WATonomous/humanoid/src/simulation/humanoid_rl_tasks/humanoid_rl_tasks/push_block/assets/textures/speckled_gray.png

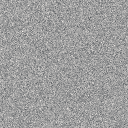
src/simulation/humanoid_rl_tasks/humanoid_rl_tasks/push_block/assets/textures/speckled_gray.png
