WATonomous/humanoid/src/simulation/humanoid_rl_tasks/humanoid_rl_tasks/push_block/assets/textures/wood_light.png

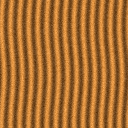
src/simulation/humanoid_rl_tasks/humanoid_rl_tasks/push_block/assets/textures/wood_light.png
