WATonomous/humanoid/docs/README.md

# Docs

The team's living documentation is the **humanoid-docs** site, not this repo:

<https://watonomous.github.io/humanoid-docs/index.html> · repo:
[`WATonomous/humanoid-docs`](https://github.com/WATonomous/humanoid-docs)

| Section | Covers |
|---|---|
| [Mechanical](https://watonomous.github.io/humanoid-docs/mechanical/) | Structure, actuators, hardware design |
| [Electrical](https://watonomous.github.io/humanoid-docs/electrical/) | Power, wiring, boards |
| [Interfacing](https://watonomous.github.io/humanoid-docs/interfacing/) | CAN, host ↔ hardware integration |
| [Firmware](https://watonomous.github.io/humanoid-docs/firmware/) | STM32 / ESP32 low-level control |
| [Software & ML](https://watonomous.github.io/humanoid-docs/software/) | Architecture, sim, teleop, imitation learning |
