WATonomous/humanoid/assets/lerobot/so101_vial_task/usd/tex/vial_opacity.png

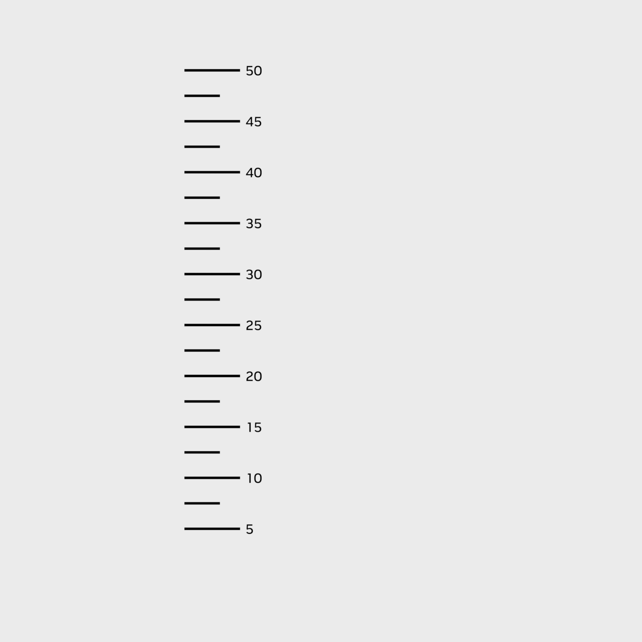
assets/lerobot/so101_vial_task/usd/tex/vial_opacity.png
