WATonomous/humanoid/assets/lerobot/so101_vial_task/usd/tex/vial_spec.png

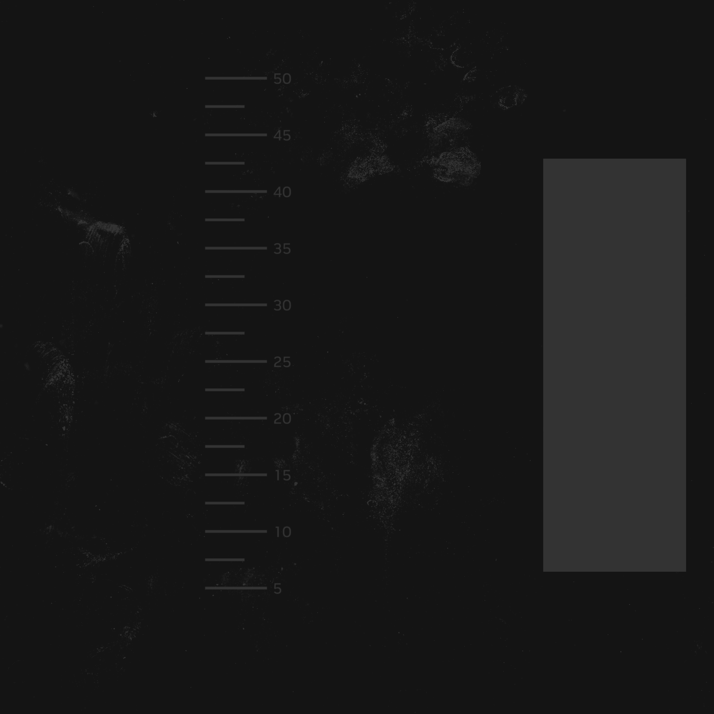
assets/lerobot/so101_vial_task/usd/tex/vial_spec.png
