WATonomous/humanoid/src/simulation/garment_fold_task/vendor_assets/scenes/Table038/texture/T_Table038_R001.png

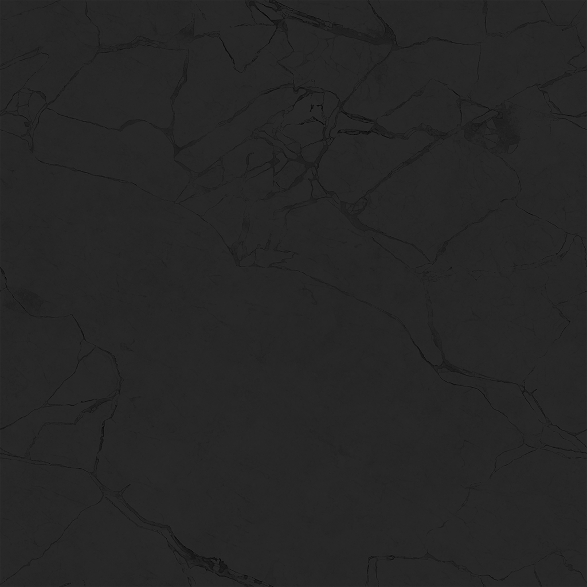
src/simulation/garment_fold_task/vendor_assets/scenes/Table038/texture/T_Table038_R001.png
