WATonomous/humanoid/src/simulation/humanoid_rl_tasks/humanoid_rl_tasks/push_block/assets/textures/wood_dark.png

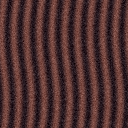
src/simulation/humanoid_rl_tasks/humanoid_rl_tasks/push_block/assets/textures/wood_dark.png
