WATonomous/humanoid/assets/pioneer_bimanual_arm/meshes/link6.STL

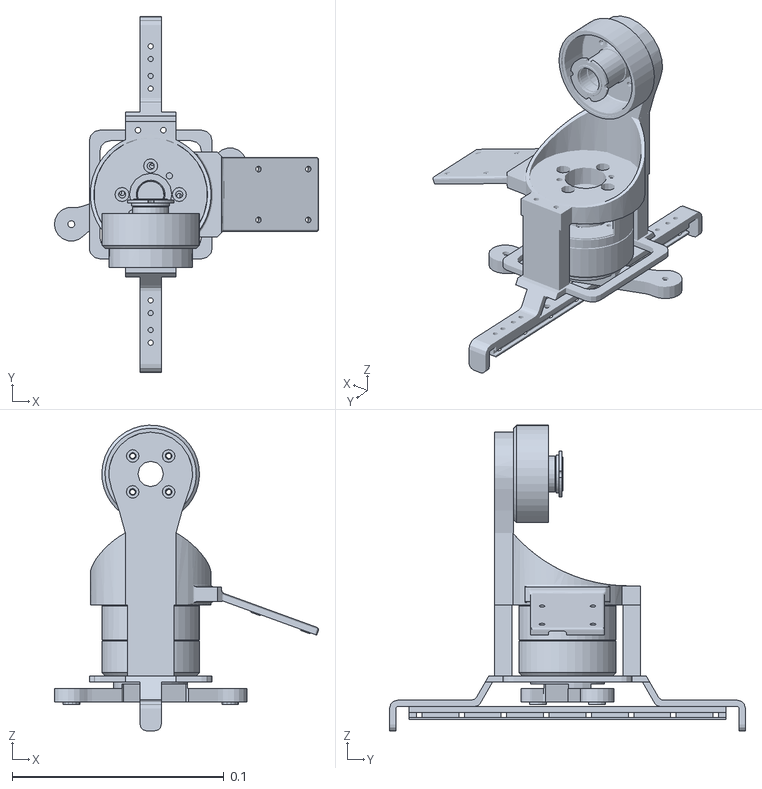
[picture p9: CAD file, 2026-08-22]
assets/pioneer_bimanual_arm/meshes/link6.STL
0.125 x 0.168 x 0.144
