WATonomous/humanoid/assets/pioneer_hand/meshes/distal_4.STL

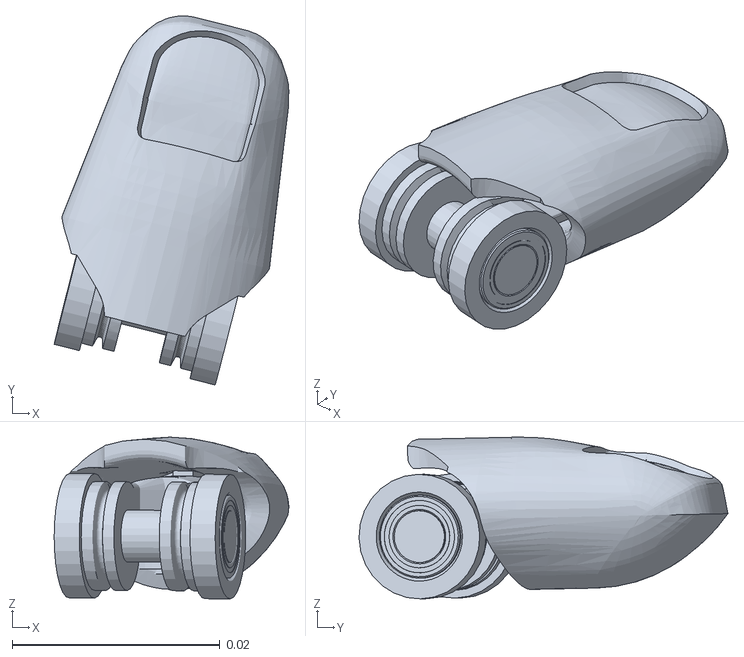
[picture p10: CAD file, 2026-07-09]
assets/pioneer_hand/meshes/distal_4.STL
0.0226 x 0.0356 x 0.0156
