WATonomous/humanoid/assets/whole_body_humanoid/meshes/Hip_A_L.STL

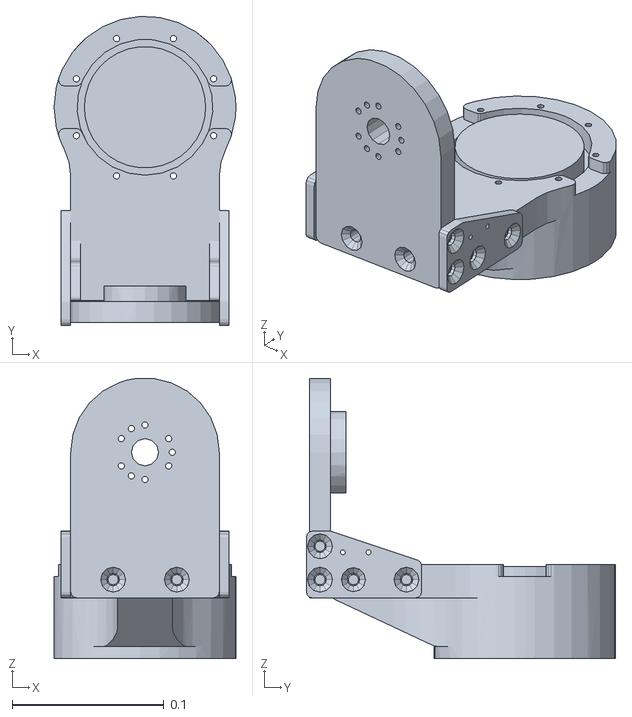
[picture p11: CAD file, 2026-07-13]
assets/whole_body_humanoid/meshes/Hip_A_L.STL
0.12 x 0.204 x 0.185
