WATonomous/humanoid/assets/pioneer_bimanual_arm/meshes/link2l.STL

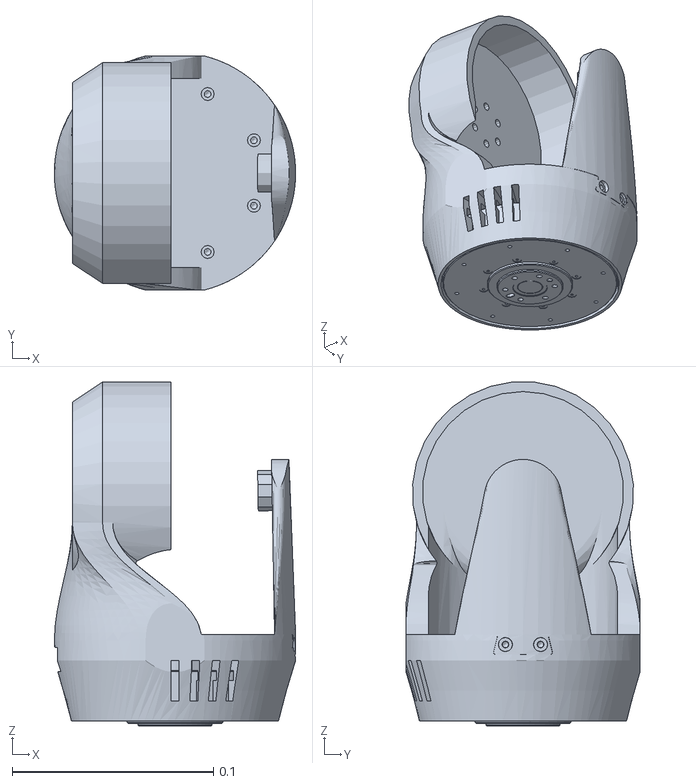
[picture p12: CAD file, 2026-08-22]
assets/pioneer_bimanual_arm/meshes/link2l.STL
0.12 x 0.116 x 0.171
