WATonomous/humanoid/assets/pioneer_hand/meshes/thumb_inter.STL

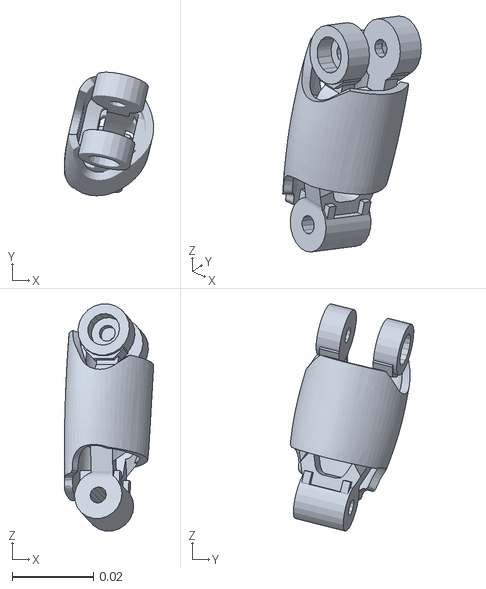
[picture p13: CAD file, 2026-07-09]
assets/pioneer_hand/meshes/thumb_inter.STL
0.022 x 0.0305 x 0.0559
