WATonomous/humanoid/assets/whole_body_humanoid/meshes/Hip_F_L.STL

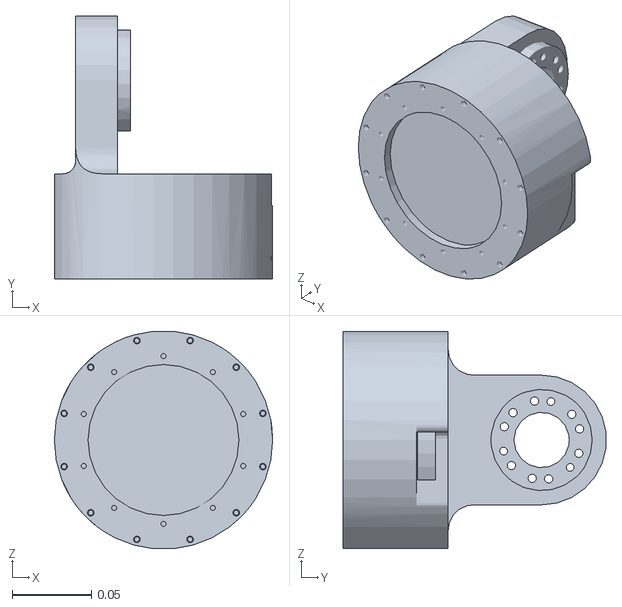
[picture p14: CAD file, 2026-07-13]
assets/whole_body_humanoid/meshes/Hip_F_L.STL
0.138 x 0.166 x 0.137
