WATonomous/humanoid/assets/pioneer_bimanual_arm/meshes/link3l.STL

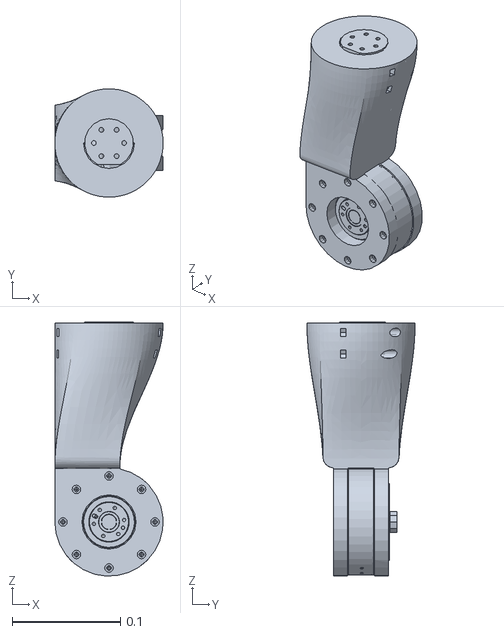
[picture p15: CAD file, 2026-08-22]
assets/pioneer_bimanual_arm/meshes/link3l.STL
0.1 x 0.1 x 0.234
