WATonomous/humanoid/assets/pioneer_hand/meshes/proximal_2.STL

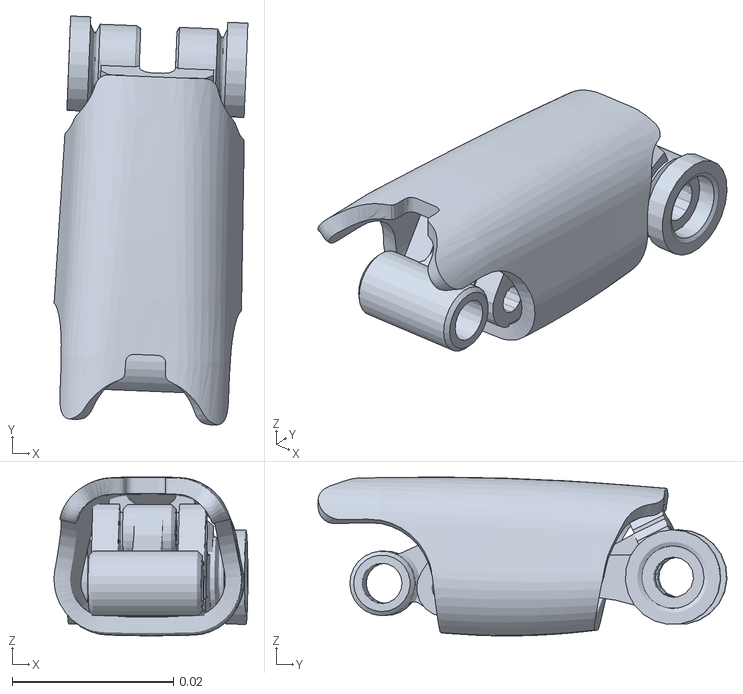
[picture p16: CAD file, 2026-07-09]
assets/pioneer_hand/meshes/proximal_2.STL
0.024 x 0.0507 x 0.0197
