WATonomous/humanoid/assets/whole_body_humanoid/meshes/Thigh_L.STL

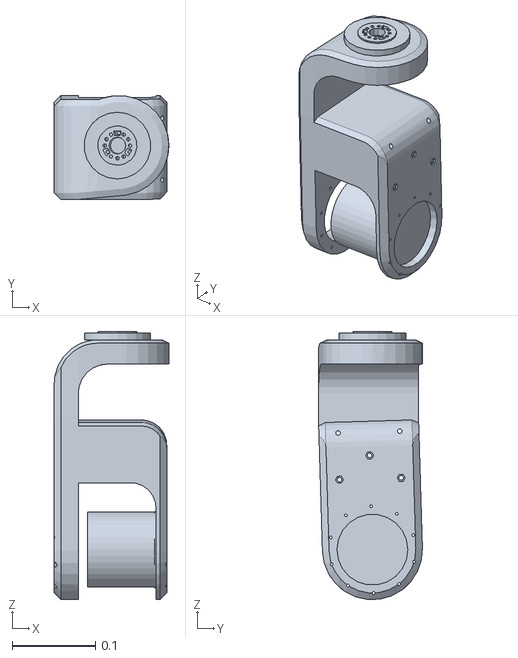
[picture p17: CAD file, 2026-07-13]
assets/whole_body_humanoid/meshes/Thigh_L.STL
0.137 x 0.125 x 0.321
