WATonomous/humanoid/assets/pioneer_bimanual_arm/meshes/link5.STL

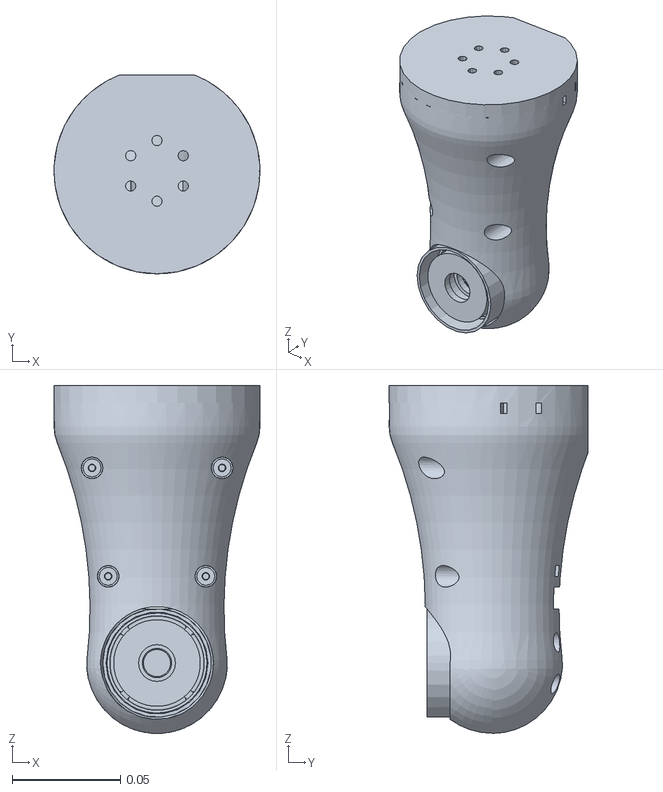
[picture p18: CAD file, 2026-08-22]
assets/pioneer_bimanual_arm/meshes/link5.STL
0.095 x 0.0917 x 0.161
