WATonomous/humanoid/assets/pioneer_hand/meshes/distal_2.STL

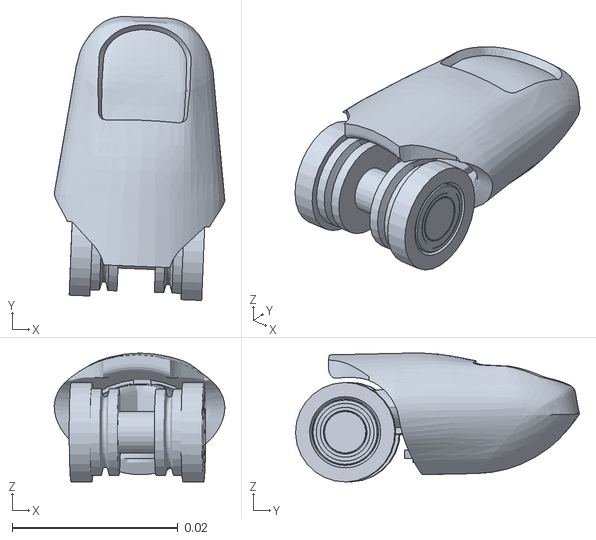
[picture p19: CAD file, 2026-07-09]
assets/pioneer_hand/meshes/distal_2.STL
0.0206 x 0.0343 x 0.0156
