WATonomous/humanoid/assets/whole_body_humanoid/meshes/Foot_L.STL

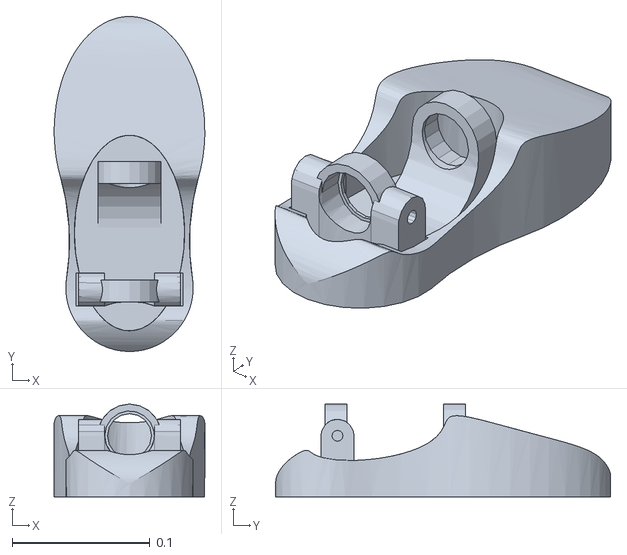
[picture p20: CAD file, 2026-07-13]
assets/whole_body_humanoid/meshes/Foot_L.STL
0.109 x 0.243 x 0.0675
