WATonomous/humanoid/assets/pioneer_bimanual_arm/meshes/link4.STL

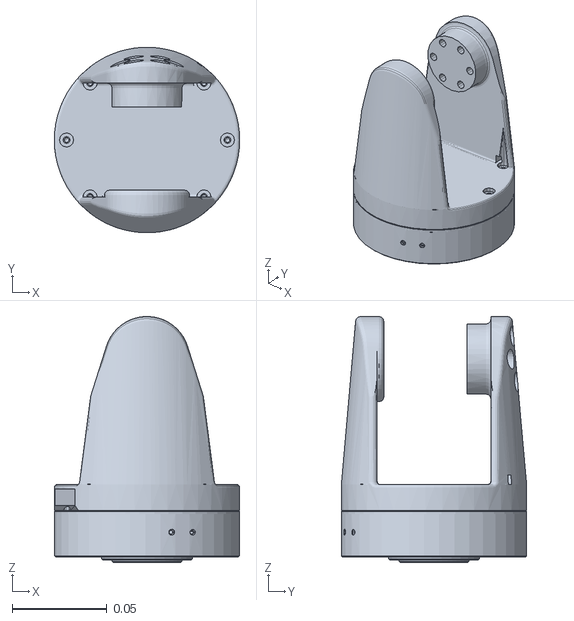
[picture p21: CAD file, 2026-08-22]
assets/pioneer_bimanual_arm/meshes/link4.STL
0.098 x 0.098 x 0.13
