WATonomous/humanoid/assets/pioneer_hand/meshes/inter_3.STL

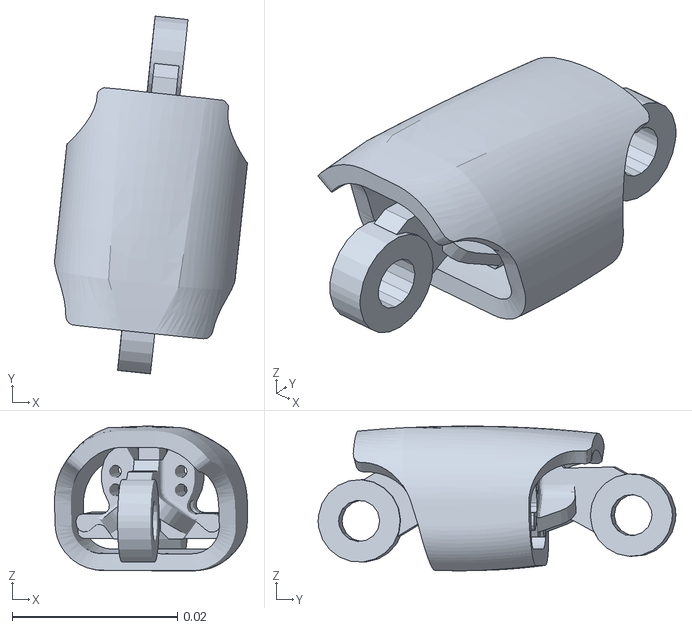
[picture p22: CAD file, 2026-07-09]
assets/pioneer_hand/meshes/inter_3.STL
0.0234 x 0.0433 x 0.0175
