WATonomous/humanoid/assets/whole_body_humanoid/meshes/Ankle_R.STL

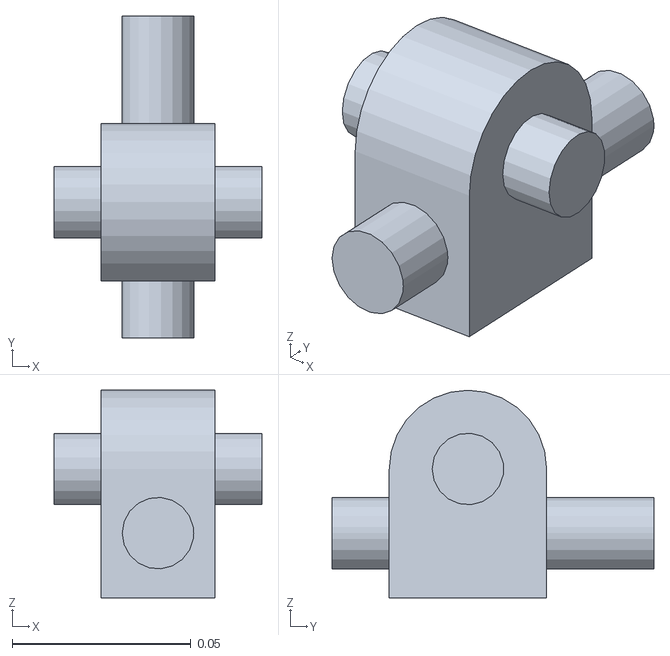
[picture p23: CAD file, 2026-07-13]
assets/whole_body_humanoid/meshes/Ankle_R.STL
0.058 x 0.09 x 0.058
