WATonomous/humanoid/assets/pioneer_bimanual_arm/meshes/link1L.STL

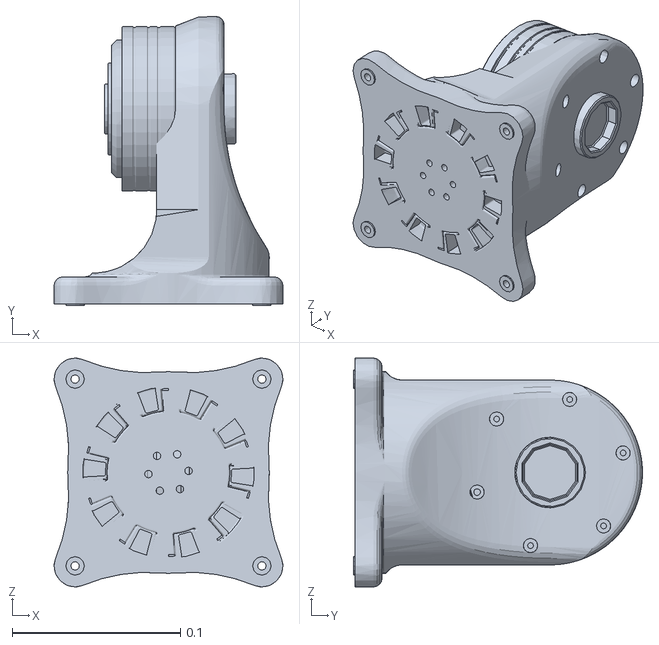
[picture p24: CAD file, 2026-08-22]
assets/pioneer_bimanual_arm/meshes/link1L.STL
0.136 x 0.172 x 0.136
