WATonomous/humanoid/assets/pioneer_hand/meshes/thumb_distal.STL

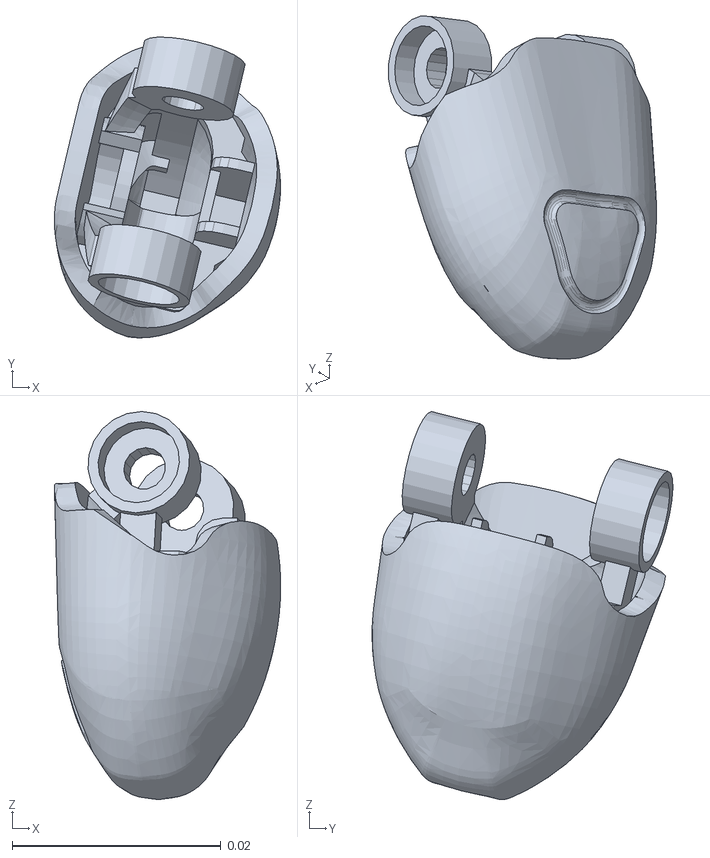
[picture p25: CAD file, 2026-07-09]
assets/pioneer_hand/meshes/thumb_distal.STL
0.0217 x 0.0288 x 0.0372
