WATonomous/humanoid/assets/whole_body_humanoid/meshes/Calf_L.STL

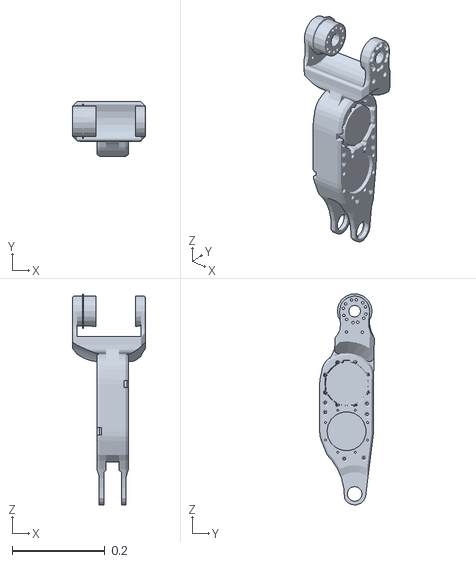
[picture p26: CAD file, 2026-07-13]
assets/whole_body_humanoid/meshes/Calf_L.STL
0.157 x 0.118 x 0.454
