WATonomous/humanoid/assets/pioneer_hand/meshes/distal_3.STL

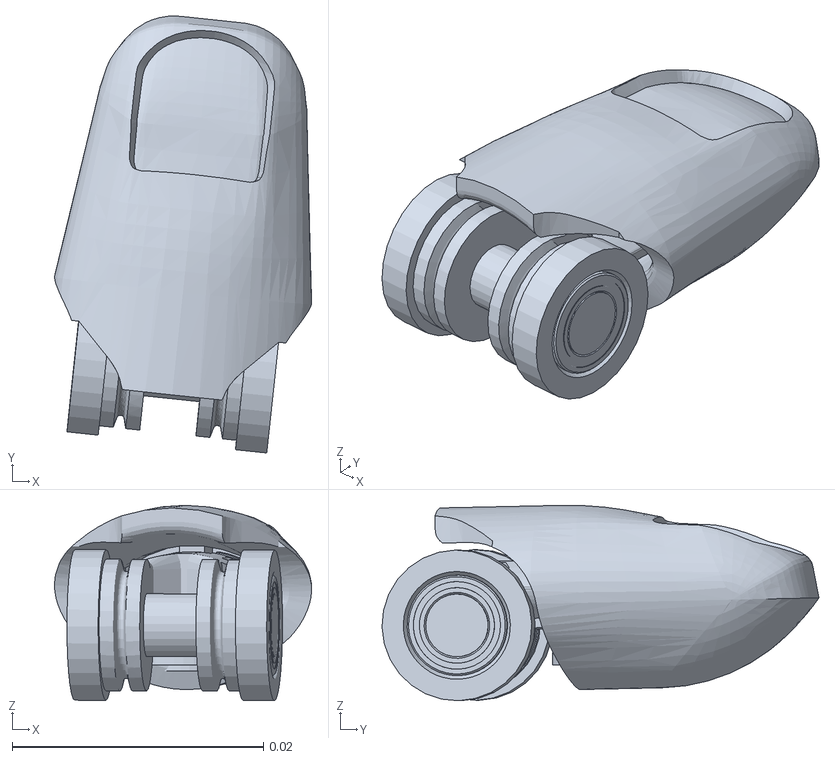
[picture p27: CAD file, 2026-07-09]
assets/pioneer_hand/meshes/distal_3.STL
0.0205 x 0.0348 x 0.0156
