WATonomous/humanoid/assets/pioneer_bimanual_arm/meshes/link7.STL

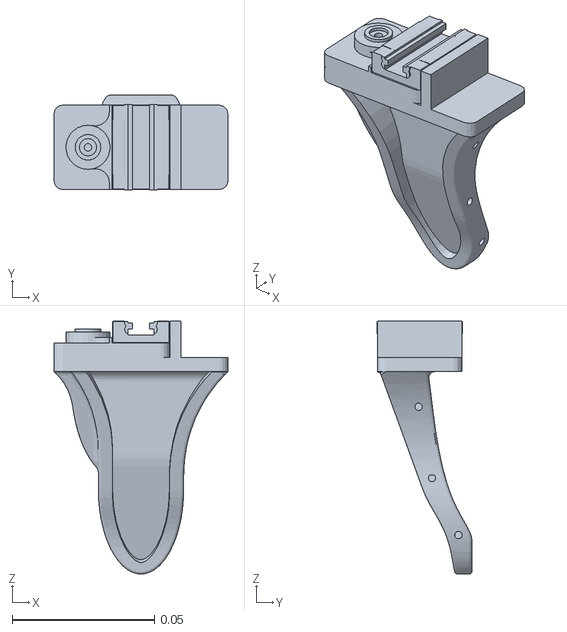
[picture p28: CAD file, 2026-08-22]
assets/pioneer_bimanual_arm/meshes/link7.STL
0.061 x 0.0334 x 0.0888
