WATonomous/humanoid/assets/pioneer_hand/meshes/hand_origin.STL

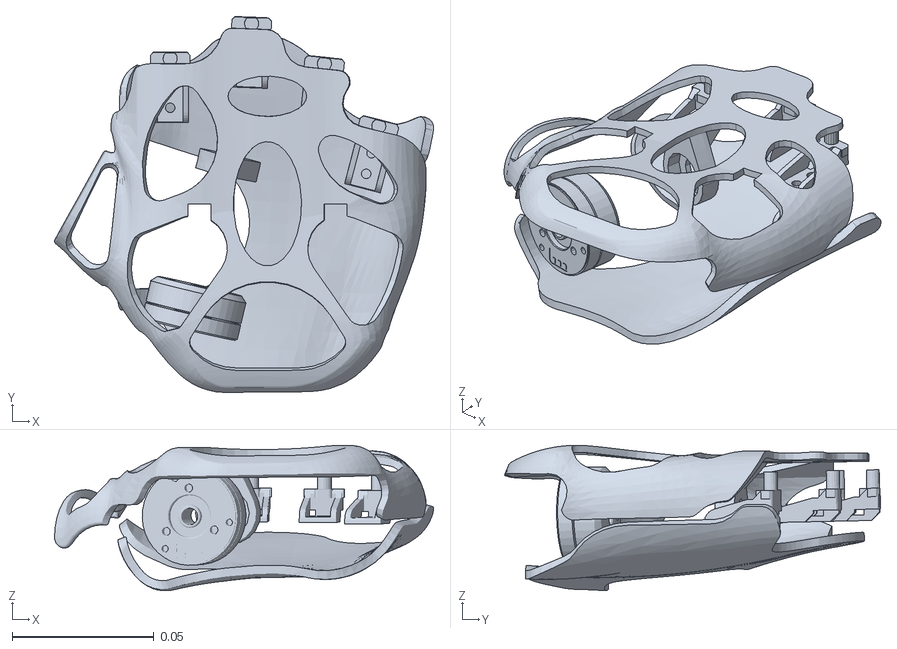
[picture p29: CAD file, 2026-07-09]
assets/pioneer_hand/meshes/hand_origin.STL
0.134 x 0.133 x 0.0513
