WATonomous/humanoid/assets/pioneer_hand/meshes/proximal_4.STL

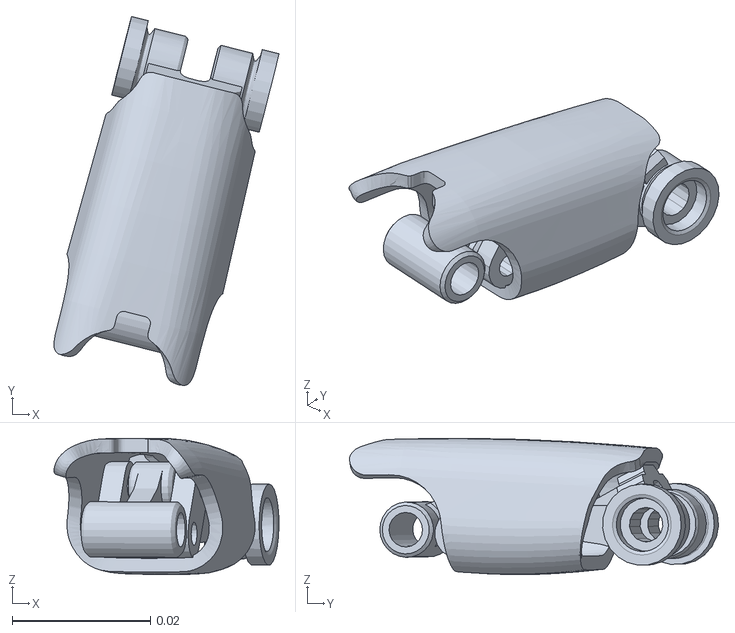
[picture p30: CAD file, 2026-07-09]
assets/pioneer_hand/meshes/proximal_4.STL
0.0325 x 0.0534 x 0.0197
