WATonomous/humanoid/assets/pioneer_hand/meshes/thumb_abduction.STL

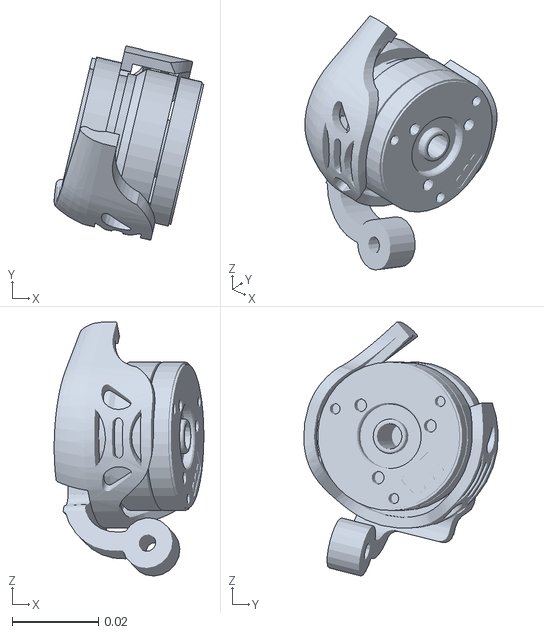
[picture p31: CAD file, 2026-07-09]
assets/pioneer_hand/meshes/thumb_abduction.STL
0.0348 x 0.0452 x 0.059
