WATonomous/humanoid/assets/pioneer_hand/meshes/abduction_1.STL

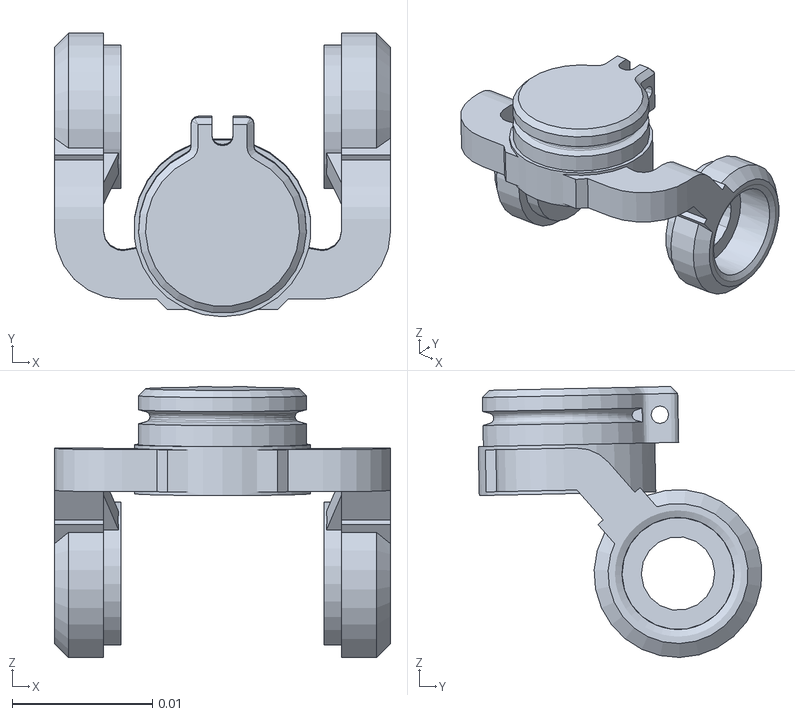
[picture p32: CAD file, 2026-07-09]
assets/pioneer_hand/meshes/abduction_1.STL
0.024 x 0.0203 x 0.0194
