WATonomous/humanoid/assets/pioneer_hand/meshes/inter_4.STL

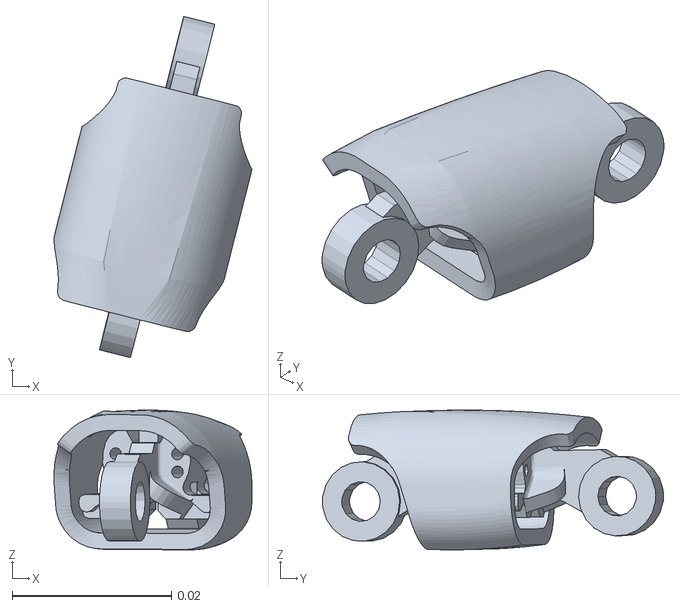
[picture p33: CAD file, 2026-07-09]
assets/pioneer_hand/meshes/inter_4.STL
0.0248 x 0.0428 x 0.0175
