WATonomous/humanoid/assets/whole_body_humanoid/meshes/base_link.STL

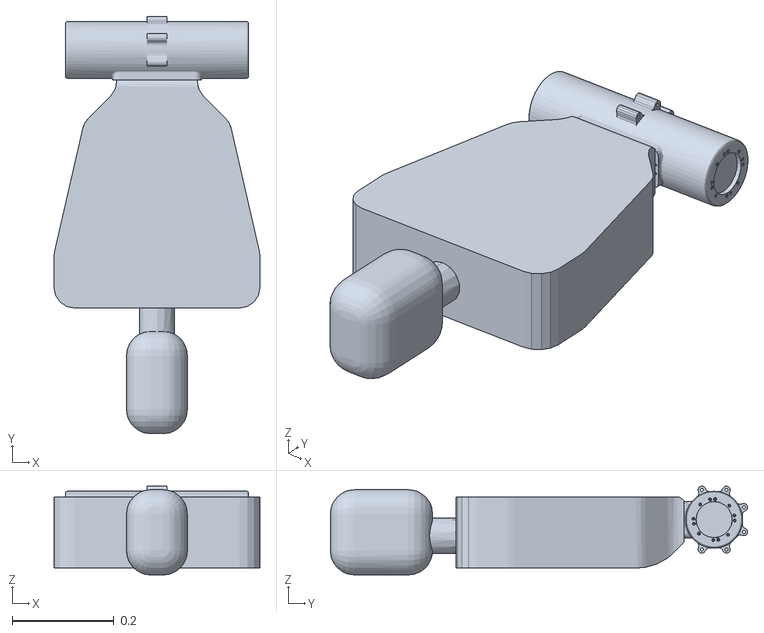
[picture p34: CAD file, 2026-07-13]
assets/whole_body_humanoid/meshes/base_link.STL
0.406 x 0.822 x 0.175
