WATonomous/humanoid/assets/pioneer_bimanual_arm/meshes/base_link.STL

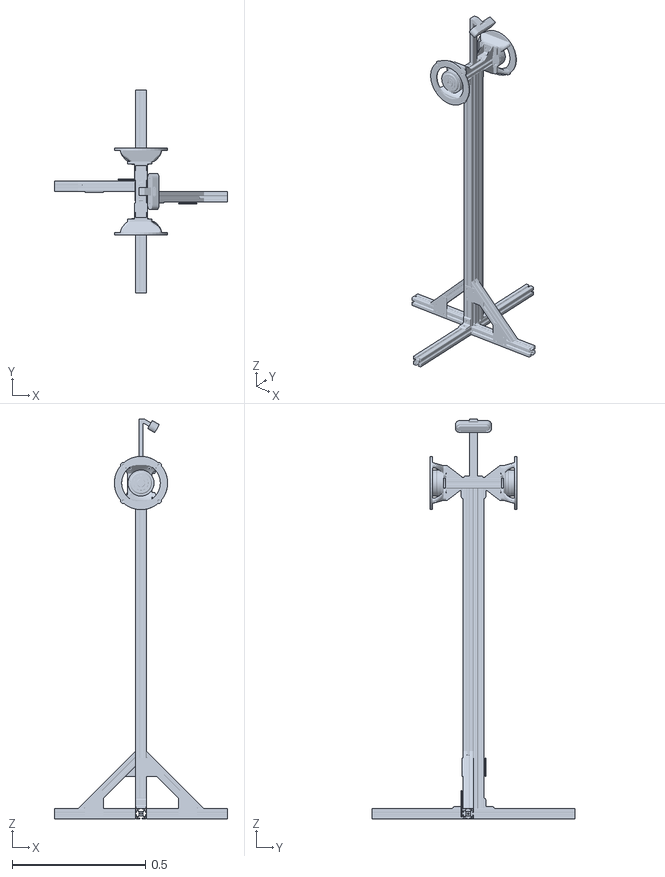
[picture p35: CAD file, 2026-08-22]
assets/pioneer_bimanual_arm/meshes/base_link.STL
0.65 x 0.762 x 1.50
