WATonomous/humanoid/assets/pioneer_hand/meshes/finger_3.STL

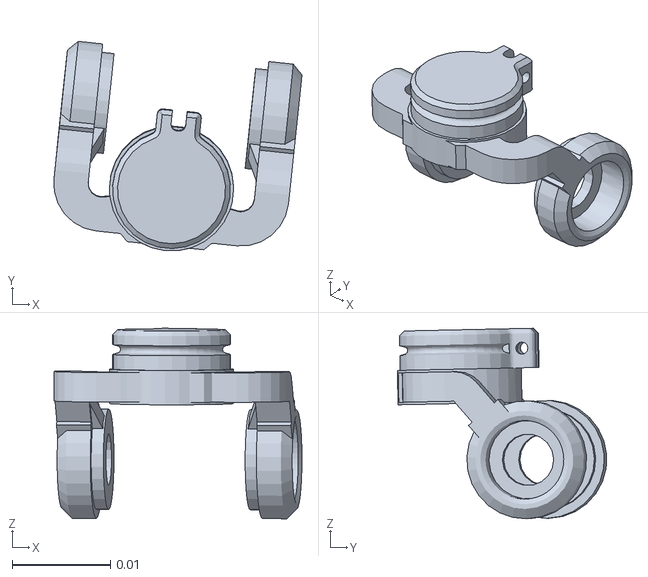
[picture p36: CAD file, 2026-07-09]
assets/pioneer_hand/meshes/finger_3.STL
0.0252 x 0.0213 x 0.0194
