WATonomous/humanoid/assets/pioneer_hand/meshes/finger_4.STL

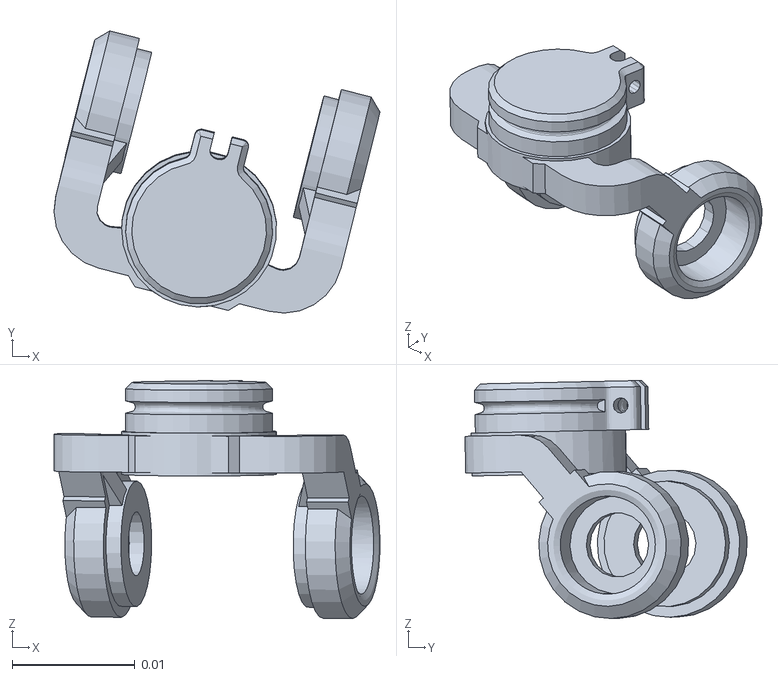
[picture p37: CAD file, 2026-07-09]
assets/pioneer_hand/meshes/finger_4.STL
0.0266 x 0.023 x 0.0194
