WATonomous/humanoid/assets/pioneer_hand/meshes/finger_1.STL

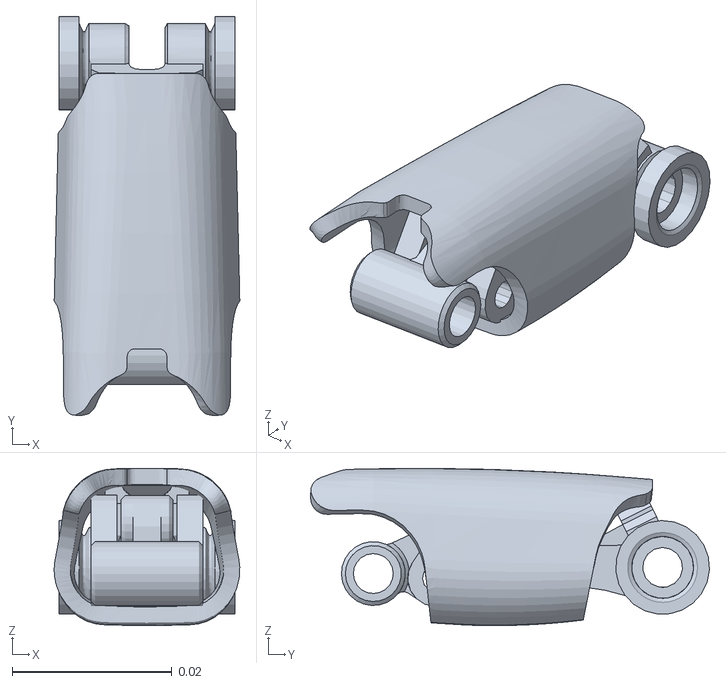
[picture p38: CAD file, 2026-07-09]
assets/pioneer_hand/meshes/finger_1.STL
0.0232 x 0.05 x 0.0197
