WATonomous/humanoid/assets/pioneer_hand/meshes/inter_1.STL

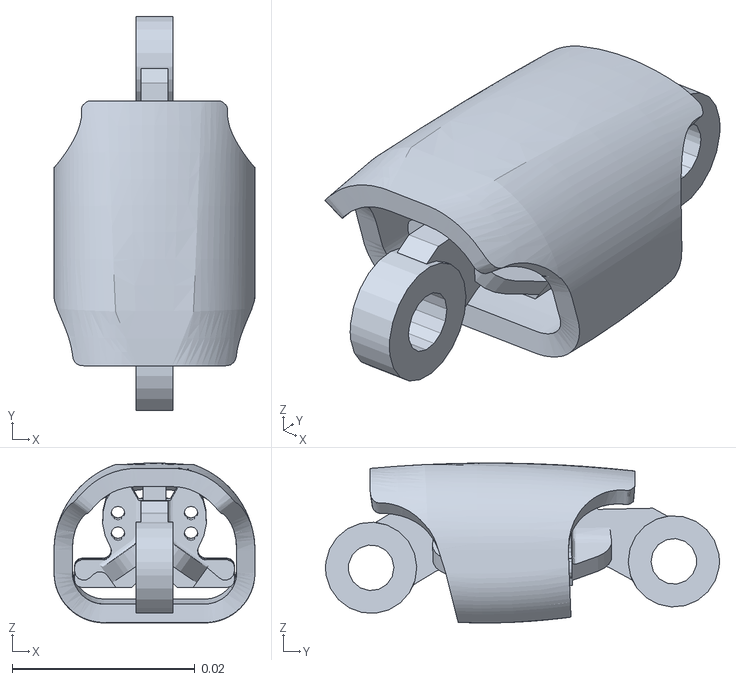
[picture p39: CAD file, 2026-07-09]
assets/pioneer_hand/meshes/inter_1.STL
0.022 x 0.0432 x 0.0175
