WATonomous/humanoid/assets/pioneer_hand/meshes/thumb.STL

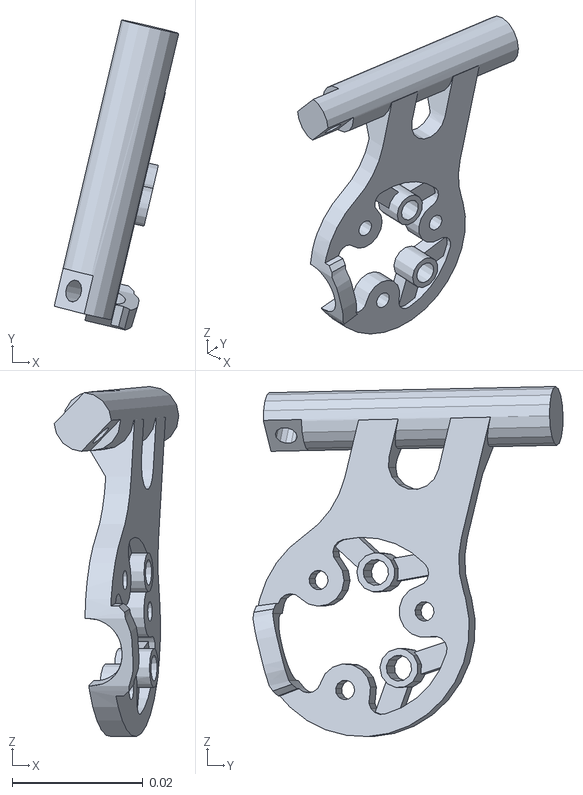
[picture p40: CAD file, 2026-07-09]
assets/pioneer_hand/meshes/thumb.STL
0.0191 x 0.0474 x 0.0535
