WATonomous/humanoid/assets/pioneer_hand/meshes/proximal_3.STL

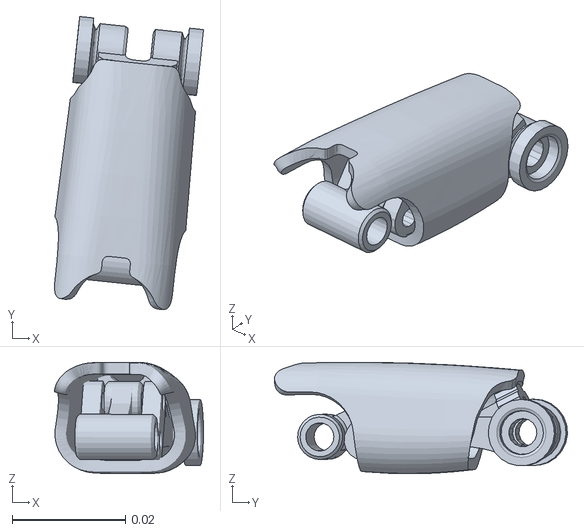
[picture p41: CAD file, 2026-07-09]
assets/pioneer_hand/meshes/proximal_3.STL
0.0263 x 0.0518 x 0.0197
