WATonomous/humanoid/(list of files, cad)

Other CAD files:
assets/pioneer_bimanual_arm/meshes/link5l.STL
assets/pioneer_hand/meshes/inter_2.STL
assets/whole_body_humanoid/meshes/Ankle_L.STL
assets/pioneer_bimanual_arm/meshes/link2.STL
assets/whole_body_humanoid/meshes/Thigh_R.STL
assets/whole_body_humanoid/meshes/Hip_A_R.STL
assets/pioneer_bimanual_arm/meshes/link6l.STL
assets/whole_body_humanoid/meshes/Hip_F_R.STL
assets/pioneer_bimanual_arm/meshes/link3.STL
assets/whole_body_humanoid/meshes/Calf_R.STL
assets/pioneer_bimanual_arm/meshes/link7l.STL
assets/whole_body_humanoid/meshes/Foot_R.STL
assets/pioneer_bimanual_arm/meshes/link4l.STL
assets/pioneer_bimanual_arm/meshes/link8l.STL
assets/pioneer_bimanual_arm/meshes/link8.STL
assets/pioneer_bimanual_arm/meshes/link1.STL
assets/pioneer_hand/meshes/finger_2.STL
assets/pioneer_hand/meshes/distal_1.STL
