WATonomous/humanoid/assets/whole_body_humanoid/usd/config.yaml

asset_path: /workspace/humanoid/assets/whole_body_humanoid/whole_body_humanoid.urdf
usd_dir: /workspace/humanoid/assets/whole_body_humanoid/usd
usd_file_name: whole_body_humanoid.usd
force_usd_conversion: false
make_instanceable: true
fix_base: false
root_link_name: base
link_density: 0.0
merge_fixed_joints: true
convert_mimic_joints_to_normal_joints: false
joint_drive:
  drive_type: force
  target_type: position
  gains:
    stiffness: 100.0
    damping: 5.0
collider_type: convex_hull
self_collision: false
replace_cylinders_with_capsules: false
collision_from_visuals: false
func: isaaclab.sim.spawners.from_files.from_files:spawn_from_urdf
visible: true
semantic_tags: null
copy_from_source: true
mass_props: null
deformable_props: null
rigid_props:
  rigid_body_enabled: null
  kinematic_enabled: null
  disable_gravity: false
  linear_damping: null
  angular_damping: null
  max_linear_velocity: null
  max_angular_velocity: null
  max_depenetration_velocity: 2.5
  max_contact_impulse: null
  enable_gyroscopic_forces: null
  retain_accelerations: null
  solver_position_iteration_count: null
  solver_velocity_iteration_count: null
  sleep_threshold: null
  stabilization_threshold: null
collision_props: null
activate_contact_sensors: true
scale: null
articulation_props:
  articulation_enabled: null
  enabled_self_collisions: false
  solver_position_iteration_count: 4
  solver_velocity_iteration_count: 4
  sleep_threshold: null
  stabilization_threshold: null
  fix_root_link: false
fixed_tendons_props: null
spatial_tendons_props: null
joint_drive_props: null
visual_material_path: material
visual_material: null
