WATonomous/humanoid/src/embedded/STM32/app/src/firmware.c

#include "../inc/common_defines.h"
#include "../inc/system.h"
#include "FreeRTOS.h"
#include "stm32g4xx.h"
#include "task.h"

#define BOOTLOADER_SIZE (0x08008000U)

// set the vector table offset of app firmware image
static void vector_setup(void) {
  SCB->VTOR = BOOTLOADER_SIZE;
}

// thread for blinking led
void blink_led(void* pvParams) {
  while (1) {
    HAL_GPIO_TogglePin(GPIOA, GPIO_PIN_5);
    // vTaskDelay(pdMS_TO_TICKS(500));
    HAL_Delay(500);
  }
}

int main() {
  vector_setup();
  HAL_Init();
  system_setup();

  __HAL_RCC_GPIOA_CLK_ENABLE();

  // Configure GPIO PIN5;
  GPIO_InitTypeDef GPIO_InitStruct;
  GPIO_InitStruct.Pin = GPIO_PIN_5;
  GPIO_InitStruct.Mode = GPIO_MODE_OUTPUT_PP;
  GPIO_InitStruct.Pull = GPIO_NOPULL;
  GPIO_InitStruct.Speed = GPIO_SPEED_FREQ_LOW;
  HAL_GPIO_Init(GPIOA, &GPIO_InitStruct);

  // create blinking led task
  xTaskCreate(blink_led, "BLINK_LED", 128, NULL, 1, NULL);

  // start FreeRTOS Scheduler
  vTaskStartScheduler();

  while (1)
    ;
}
