WATonomous/humanoid/src/embedded/STM32/src/Drivers/FDCAN_STM32.cpp

/* USER CODE BEGIN PFP */

#include "FDCAN_STM32.h"
#include <SimpleFOC.h>
FDCAN_HandleTypeDef hfdcan2;

static void check_can_bus(FDCAN_HandleTypeDef* hfdcan) {
  FDCAN_ProtocolStatusTypeDef protocolStatus = {};

  HAL_FDCAN_GetProtocolStatus(hfdcan, &protocolStatus);
  if (protocolStatus.BusOff) {
    CLEAR_BIT(hfdcan->Instance->CCCR, FDCAN_CCCR_INIT);
  }
}

void HAL_FDCAN_ErrorStatusCallback(FDCAN_HandleTypeDef* hfdcan, uint32_t ErrorStatusITs) {
  if (hfdcan == &hfdcan2) {
    if ((ErrorStatusITs & FDCAN_IT_BUS_OFF) != RESET) {
      check_can_bus(hfdcan);
    }
  }
}

void MX_FDCAN2_Init(void) {

  hfdcan2.Instance = FDCAN2;
  hfdcan2.Init.ClockDivider = FDCAN_CLOCK_DIV1;
  hfdcan2.Init.FrameFormat = FDCAN_FRAME_CLASSIC;
  hfdcan2.Init.Mode = FDCAN_MODE_NORMAL;
  hfdcan2.Init.AutoRetransmission = ENABLE;
  hfdcan2.Init.TransmitPause = DISABLE;
  hfdcan2.Init.ProtocolException = ENABLE;
  hfdcan2.Init.NominalPrescaler = 1;
  hfdcan2.Init.NominalSyncJumpWidth = 7;
  hfdcan2.Init.NominalTimeSeg1 = 40;
  hfdcan2.Init.NominalTimeSeg2 = 7;
  hfdcan2.Init.DataPrescaler = 2;
  hfdcan2.Init.DataSyncJumpWidth = 5;
  hfdcan2.Init.DataTimeSeg1 = 18;
  hfdcan2.Init.DataTimeSeg2 = 5;
  hfdcan2.Init.StdFiltersNbr = 1;
  hfdcan2.Init.ExtFiltersNbr = 0;
  hfdcan2.Init.TxFifoQueueMode = FDCAN_TX_FIFO_OPERATION;
  if (HAL_FDCAN_Init(&hfdcan2) != HAL_OK) {
    Error_Handler();
  }
}

static uint32_t HAL_RCC_FDCAN_CLK_ENABLED = 0;

void HAL_FDCAN_MspInit(FDCAN_HandleTypeDef* fdcanHandle) {

  GPIO_InitTypeDef GPIO_InitStruct = {0};
  RCC_PeriphCLKInitTypeDef PeriphClkInit = {0};
  if (fdcanHandle->Instance == FDCAN2) {
    /** Initializes the peripherals clocks
     */
    PeriphClkInit.PeriphClockSelection = RCC_PERIPHCLK_FDCAN;
    PeriphClkInit.FdcanClockSelection = RCC_FDCANCLKSOURCE_PLL;
    if (HAL_RCCEx_PeriphCLKConfig(&PeriphClkInit) != HAL_OK) {
      Error_Handler();
    }

    /* FDCAN2 clock enable */
    HAL_RCC_FDCAN_CLK_ENABLED++;
    if (HAL_RCC_FDCAN_CLK_ENABLED == 1) {
      __HAL_RCC_FDCAN_CLK_ENABLE();
    }

    __HAL_RCC_GPIOB_CLK_ENABLE();
    /**FDCAN2 GPIO Configuration
    PB12     ------> FDCAN2_RX
    PB13     ------> FDCAN2_TX
    */
    GPIO_InitStruct.Pin = GPIO_PIN_12 | GPIO_PIN_13;
    GPIO_InitStruct.Mode = GPIO_MODE_AF_PP;
    GPIO_InitStruct.Pull = GPIO_NOPULL;
    GPIO_InitStruct.Speed = GPIO_SPEED_FREQ_LOW;
    GPIO_InitStruct.Alternate = GPIO_AF9_FDCAN2;
    HAL_GPIO_Init(GPIOB, &GPIO_InitStruct);

    /* FDCAN2 interrupt Init */
    HAL_NVIC_SetPriority(FDCAN2_IT0_IRQn, 0, 0);
    HAL_NVIC_EnableIRQ(FDCAN2_IT0_IRQn);
    HAL_NVIC_SetPriority(FDCAN2_IT1_IRQn, 0, 0);
    HAL_NVIC_EnableIRQ(FDCAN2_IT1_IRQn);
  }
}

void HAL_FDCAN_MspDeInit(FDCAN_HandleTypeDef* fdcanHandle) {

  if (fdcanHandle->Instance == FDCAN2) {
    /* Peripheral clock disable */
    HAL_RCC_FDCAN_CLK_ENABLED--;
    if (HAL_RCC_FDCAN_CLK_ENABLED == 0) {
      __HAL_RCC_FDCAN_CLK_DISABLE();
    }

    /**FDCAN2 GPIO Configuration
    PB12     ------> FDCAN2_RX
    PB13     ------> FDCAN2_TX
    */
    HAL_GPIO_DeInit(GPIOB, GPIO_PIN_12 | GPIO_PIN_13);

    /* FDCAN2 interrupt Deinit */
    HAL_NVIC_DisableIRQ(FDCAN2_IT0_IRQn);
    HAL_NVIC_DisableIRQ(FDCAN2_IT1_IRQn);
  }
}
