WATonomous/humanoid/src/embedded/STM32/src/Drivers/ring_buffer.h

#ifndef RING_BUFFER_H
#define RING_BUFFER_H

#include "../../app/inc/common_defines.h"

#define RING_BUF_SIZE 128U

typedef struct ring_buffer_s {
  uint32_t read_index;
  uint32_t write_index;
  uint8_t* buf;
  uint32_t size;
} ring_buffer_t;

void ring_buffer_init(ring_buffer_t* rb, uint8_t* buf, uint32_t size);
bool ring_buffer_read(ring_buffer_t* rb, uint8_t* byte);
bool ring_buffer_write(ring_buffer_t* rb, uint8_t byte);
bool ring_buffer_empty(ring_buffer_t* rb);

#endif /* RING_BUFFER_H */
