WATonomous/humanoid/src/interfacing/can/scripts/joint_config.py

"""The arm's limits (hardware_mapping.yaml, safety_limits.yaml), read the way joint_command reads
them. Used by arm_roundtrip.py, telemetry_record.py and calibrate_arm.py. No ROS imports.

Frames (see joint_command_core.cpp applyCalibration):
  command frame  degrees, what ArmPose carries and what the limits are written in
  motor frame    direction * (q_cmd - zero_offset) degrees; MIT drives take it in radians
"""

from __future__ import annotations

from pathlib import Path
from typing import Any, Dict, List, Optional, Tuple

import yaml

# The six ArmPose slots, in message order -- identical to joint_command_core.cpp's jointPaths().
ARM_POSE_JOINTS = [
    ("shoulder", "pitch"), ("shoulder", "roll"), ("shoulder", "yaw"),
    ("elbow", "pitch"), ("elbow", "roll"), ("wrist", "pitch"),
]
ARM_POSE_NAMES = [f"{group}.{joint}" for group, joint in ARM_POSE_JOINTS]

# The repo copy, found relative to this file (src/interfacing/can/scripts -> src/interfacing).
_REPO_CONFIG = Path(__file__).resolve().parents[2] / "joint_command" / "config"

DEFAULT_MAPPINGS = [
    "/calibration/hardware_mapping.yaml",  # bind-mounted in both containers
    "/root/ament_ws/src/interfacing/joint_command/config/hardware_mapping.yaml",
    "/root/ament_ws/src/joint_command/config/hardware_mapping.yaml",
    str(_REPO_CONFIG / "hardware_mapping.yaml"),
]

SAFETY_LIMITS = [
    "/opt/joint_command_config/safety_limits.yaml",
    "/root/ament_ws/src/joint_command/config/safety_limits.yaml",
    "/root/ament_ws/src/interfacing/joint_command/config/safety_limits.yaml",
    str(_REPO_CONFIG / "safety_limits.yaml"),
]

# can/config/mit_profiles.yaml: which protocol family each drive speaks (gl2 | ak).
MIT_PROFILES = [
    str(Path(__file__).resolve().parent.parent / "config" / "mit_profiles.yaml"),
    "/opt/watonomous/can/share/can/config/mit_profiles.yaml",
]

# Keys a joint block may override; anything missing falls back to safety.global, exactly as
# JointCommandCore::loadJointSafetyConfig does.
_SAFETY_KEYS = ("velocity_max", "delta_max", "control_type", "mit_kp", "mit_kd",
                "mit_max_torque", "mit_max_track_err", "mit_feedback_timeout", "mit_family",
                "mit_fault_kd", "enable_position_clamp", "enable_velocity_limit",
                "gravity_ff_scale", "gravity_ff_max_torque", "urdf_direction", "urdf_offset_deg",
                "gravity_assume_deg")


def _first_existing(candidates: List[str]) -> Optional[Path]:
    for path in candidates:
        if path and Path(path).exists():
            return Path(path)
    return None


def find_mapping(explicit: Optional[str]) -> Path:
    found = _first_existing([explicit] if explicit else DEFAULT_MAPPINGS)
    if found is None:
        raise SystemExit("could not find hardware_mapping.yaml; pass --mapping PATH "
                         f"(looked in: {', '.join(DEFAULT_MAPPINGS)})")
    return found


def find_safety_limits(explicit: Optional[str]) -> Optional[Path]:
    return _first_existing([explicit] if explicit else SAFETY_LIMITS)


def drive_family(motor_id: int) -> Optional[str]:
    """mit_profiles.yaml family for this id (gl2 / ak), or None if unknown."""
    path = _first_existing(MIT_PROFILES)
    if path is None:
        return None
    motors = (yaml.safe_load(path.read_text(encoding="utf-8")) or {}).get("motors", {}) or {}
    return (motors.get(str(motor_id)) or {}).get("family")


def installed_joint_command_config() -> Optional[Path]:
    """joint_command_node's INSTALLED config dir -- what it enforces until rebuilt (needs ROS)."""
    try:
        from ament_index_python.packages import get_package_share_directory
        return Path(get_package_share_directory("joint_command")) / "config"
    except Exception:  # noqa: BLE001 - no ROS, or the package is not installed here
        return None


def same_yaml(a: Path, b: Path) -> bool:
    """Equal content, ignoring comments and formatting."""
    return (yaml.safe_load(a.read_text(encoding="utf-8")) ==
            yaml.safe_load(b.read_text(encoding="utf-8")))


def load_joint_map(path: Path, arm_side: str) -> Dict[int, dict]:
    """-> {motor_id: {"name", "direction", "zero_offset", "lower", "upper", "slot"}}"""
    data = yaml.safe_load(path.read_text(encoding="utf-8"))
    if arm_side not in data:
        raise SystemExit(f"arm side '{arm_side}' not in {path} (have {list(data)})")

    out: Dict[int, dict] = {}

    def walk(node, prefix: str) -> None:
        if not isinstance(node, dict):
            return
        if "can_id" in node:
            out[int(node["can_id"])] = {
                "name": prefix,
                "direction": float(node.get("direction", 1)) or 1.0,
                "zero_offset": float(node.get("zero_offset", 0.0)),
                "lower": float(node.get("lower_limit", float("-inf"))),
                "upper": float(node.get("upper_limit", float("inf"))),
                "limit_range": bool(node.get("limit_range", False)),
                "slot": None,
            }
            return
        for key, child in node.items():
            walk(child, f"{prefix}.{key}" if prefix else key)

    walk(data[arm_side], "")
    # Tag the six joints an ArmPose carries, so their setpoints can be matched up.
    for slot, (group, joint) in enumerate(ARM_POSE_JOINTS):
        node = data[arm_side].get(group, {}).get(joint)
        if node and int(node["can_id"]) in out:
            out[int(node["can_id"])]["slot"] = slot
    return out


def load_joint_safety(path: Optional[Path]) -> Tuple[Dict[str, Any], Dict[str, Dict[str, Any]]]:
    """-> (global block, {"group.joint": joint block merged over global})."""
    if path is None:
        return {}, {}
    cfg = (yaml.safe_load(path.read_text(encoding="utf-8")) or {}).get("safety", {}) or {}
    default = cfg.get("global", {}) or {}
    joints: Dict[str, Dict[str, Any]] = {}
    for group, members in (cfg.get("joints") or {}).items():
        for joint, node in (members or {}).items():
            node = node or {}
            joints[f"{group}.{joint}"] = {key: node.get(key, default.get(key))
                                          for key in _SAFETY_KEYS}
    return default, joints


def joint_safety(path: Optional[Path], name: str) -> Dict[str, Any]:
    """One joint's effective block; a joint with no entry (e.g. the gripper) gets global."""
    default, joints = load_joint_safety(path)
    if name in joints:
        return joints[name]
    return {key: default.get(key) for key in _SAFETY_KEYS}


def load_safety_limits(explicit: Optional[str]):
    """({joint: velocity_max_dps}, {joint: mit thresholds}) for the plots; empty if missing."""
    _, joints = load_joint_safety(find_safety_limits(explicit))
    vmax, mit = {}, {}
    for name, block in joints.items():
        vmax[name] = float(block.get("velocity_max") or 0)
        if int(block.get("control_type") if block.get("control_type") is not None else -1) == 0:
            mit[name] = {
                "mit_kp": block.get("mit_kp"),
                "mit_kd": block.get("mit_kd"),
                "max_torque_nm": block.get("mit_max_torque"),
                "max_track_err_deg": block.get("mit_max_track_err"),
            }
    return vmax, mit


def max_torque_by_joint(explicit: Optional[str]) -> Dict[str, float]:
    """Every joint's mit_max_torque, MIT or not -- the testing ceiling a run is judged against."""
    _, joints = load_joint_safety(find_safety_limits(explicit))
    return {name: float(block["mit_max_torque"]) for name, block in joints.items()
            if block.get("mit_max_torque") is not None}


def motor_to_cmd_deg(info: dict, motor_deg: float) -> float:
    """Inverse of joint_command's calibration: cmd = zero_offset + motor / direction."""
    return info["zero_offset"] + motor_deg / (info["direction"] or 1.0)


def cmd_to_motor_deg(info: dict, cmd_deg: float) -> float:
    """joint_command's calibration: motor = direction * (cmd - zero_offset)."""
    return (info["direction"] or 1.0) * (cmd_deg - info["zero_offset"])


def motor_frame_limits_deg(info: dict) -> Tuple[Optional[float], Optional[float]]:
    """Command-frame limits in the motor frame (deg, low first); (None, None) without limits."""
    if not info.get("limit_range"):
        return (None, None)
    a = cmd_to_motor_deg(info, info["lower"])
    b = cmd_to_motor_deg(info, info["upper"])
    return (min(a, b), max(a, b))
