WATonomous/humanoid/(commit log)

2023-08-21 created gazebo server docker container
    [building_robot.sdf]
2023-08-22 migrated monorepov2 infrastructure, setup gazebo ros bridge, full demo with gazebo, foxglove, and 3D lidar
    [building_robot.sdf, sensors_tutorial.sdf]
2023-08-30 added camera sensor and added robot urdf
    [building_robot.sdf, robot.urdf, robot_env.sdf]
2023-09-01 brought in samples and seccomp
2023-09-01 changing samples profile
2023-09-03 cleanup pycache and moved launch to src/gazebo
    [robot.urdf, robot_env.sdf]
2023-09-06 starting work on maze nav env
    [env.sdf, robot_env.sdf]
2023-09-06 added robot package and occupancy, nav, and control blank nodes
    [env.sdf, env.urdf]
2023-09-16 working new gazebo map
    [env.urdf, robot_env.sdf]
2024-01-21 fixing samples
2024-10-16 fixes to watod and tfs
    [env.urdf]
2024-11-20 costmap module
    [robot_env.sdf]
2024-12-29 adding an odometry spoofer
2025-01-07 completed assignment (this commit is intentional :3)
    [robot_env.sdf]
2025-01-08 fixes to merge conflicts
    [params.yaml]
2025-01-10 hotfix with urdf url
2025-01-16 fix env URDF
    [env.urdf]
2025-02-19 CI set up (#2)
    cli working - without sanitization
    [env.urdf, robot.urdf, robot_env.sdf]
2025-04-20 Miekale embedded structure (#6)
    * updating arch
    * Adding embedded directory, changing src -> autonomy
    * repairing actions
    * merging to main
    * actions updates
    * fix: naming convention
    * Fix code style issues with Autopep8
    * Fix code style issues with clang_format
    ---------
    [params.yaml]
2025-06-11 First iteration of arm pose message format (#11)
    * Create First Iteration of Common Message Formats
    * Update autonomy/wato_msgs/common_msgs/package.xml
    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
2025-07-12 Adding Humanoid Hand RL (#14)
    * Adding Humanoid Hand RL
    * Minor addition
    * bumping python version
    * repo clean up
    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
    [config.yaml]
2025-07-19 Add Simulation Kinematics Scripts
2025-07-19 Revert "Merge pull request #18 from WATonomous/fix-add-simulation-kinematics-scripts"
    This reverts commit f46af8351d94eb1c3b973566d521dc3943f6923d, reversing
    changes made to b91c1d8aff1c3a722b1de5117ee93e2598c3d6e2.
2025-10-19 Stm32 fdcan simple foc interfacing (#23)
    * Merged gimbal motor test code with humanoid repo on embedded branch
    * Initialized Platform IO STM32G474 development files
    * Updated Platform IO STM32G474 development files
    * bootloader with freeRTOS config (#15)
    * added FDCAN, Clock drivers
    * Added necessary FDCAN, TIMER driver files
    * Fix library capitalization
    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
    [FDCAN_STM32.cpp, FDCAN_STM32.h, SysClock.cpp, TIM.cpp, TIM.h]
2026-01-31 Refactor and optimize FDCAN driver implementation for STM32G474
2026-01-31 Enhance FDCAN driver performance and code structure for STM32G474
2026-02-06 Fix/repo cleaning (#27)
    * cleaning stm file
    * removing stm32 director and controller docker file
2026-02-06 new lint fix (#26)
    * new lint fix
    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
    [FDCAN_STM32.cpp, FDCAN_STM32.h, SysClock.cpp, TIM.cpp, TIM.h]
2026-02-19 Gtranqui interfacing (#30)
    * creating can package: debugging docker up
    * interfacing docker workind
    * updating to new structure
    * moving to autonomy
    * adding changes
    * Mounting CANable onto /dev/canable port
    * Convert CAN package to C++
    * Add CAN package README.md template
    * Added TODOs
    * Successfully run slcand to initialize can0 as a can device with master settings
    * Remove unecessary params
    * Added TODO comments on the empty functions
    * Add README.md
    * Add setup script comment
    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
    [can_core.cpp, can_core.hpp, can_node.cpp, can_node.hpp, params.yaml]
2026-03-11 update humanoid sim RL with full arm hand
    [CMC_THUMB_v1_1.stl, DIP_INDEX_v1_1.stl, DIP_MIDDLE_v1_1.stl, DIP_PINKY_v1_1.stl, DIP_RING_v1_1.stl, IP_THUMB_v1_1.stl, MCP_INDEX_v1_1.stl, MCP_MIDDLE_v1_1.stl]
2026-03-12 Improve arm hand RL
2026-03-18 add dex_retargeting library test with laptop camera
2026-04-24 Integrating DBC file for interfacing (#46)
    * initial messages
    * interfacing refactor, dbcppp installed
    * adding left flag, adding motor command callback
    * adding motorcmd, adding common_msgs, application builds
    * adding limiting bool
    * adding decode file, updating dbc to support dbcppp
    * installed dbc
    * adding encoding
    * dbc updates
    * updating can run, cube mars debugging, motor command update
    * working extended id publishing
    * adding multiple mode support for motors
    * adding publisher for motor feed back
    * removing comments
    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
    [hardware_mapping.yaml]
2026-05-06 Update MotorCmd.msg (#48)
2026-05-13 Fabrics dimension reduction test
    [arm_assembly.urdf]
2026-05-13 removing sim
    [arm_assembly.urdf]
2026-05-21 removing arm assembly msg
    [arm_assembly.urdf]
2026-05-21 trying again
    [arm_assembly.urdf]
2026-05-27 init camera pos
2026-07-09 feat: add camera/keyboard teleoperation and IL pipeline
    Squashed from PRs #57, #58, #59, #60, #67, #70.
    [armDouble.SLDASM.csv, armDouble.SLDASM.urdf, arm_assembly_fixed.urdf, base_link.STL, exportedthing.csv, exportedthing.urdf, link1.STL, link1L.STL]
2026-07-09 new changes
    [left_CMC_THUMB_v1_1.stl, left_DIP_INDEX_v1_1.stl, left_DIP_MIDDLE_v1_1.stl, left_DIP_PINKY_v1_1.stl, left_DIP_RING_v1_1.stl, left_IP_THUMB_v1_1.stl, left_MCP_INDEX_v1_1.stl, left_MCP_MIDDLE_v1_1.stl]
2026-07-09 Reorganized the files
    [arm_assembly_fixed.urdf, simple_door.urdf]
2026-07-09 Add SO101 vial-task assets under Git LFS.
    Track simulation USD/PNG via .gitattributes, migrate the existing SO101
    follower mesh to LFS, and vendor vial-task props from NVIDIA's workshop
    (lightbox, mat, vials, rack, textures) with a GitHub sync script.
2026-07-09 Added camera configuration for the intel realsense D455 config
2026-07-09 Consolidate Isaac Sim recording to single GPU-buffered strategy
    All Isaac Sim recording now uses SimLeRobotRecorder (GPU tensor buffering +
    async CPU flush) instead of the frame-by-frame RecordSession pattern.
    - Add humanoid_il/sim_recorder.py: generic SimLeRobotRecorder (no Isaac Sim
    deps, accepts numpy or torch, joint_names param, clean save/cancel API,
    num_episodes/is_complete, fixed __del__)
    - Delete humanoid_il/sim_session.py (create_sim_record_session removed)
    - Add [sim] optional dep group to humanoid_il pyproject.toml
    - Update so101_leader_teleop.py, so101_keyboard_teleop.py, keyboard_teleop.py
    to use SimLeRobotRecorder with EpisodeFlags/EpisodeKeyboard for S/N/D/Esc
    - Update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
2026-07-09 Store bimanual arm USD assets in git instead of LFS.
    Exclude wato_bimanual_arm from LFS so full mesh and USD files are committed directly.
2026-07-09 fix usd joint limit issue for task space controller'
2026-07-09 Add LEGR locomotion training setup (#95)
    Adds the LEGR robot model assets and Isaac Lab locomotion setup.
    This includes the LEGR articulation config, flat/rough locomotion task configs, reward terms, task registration, and diagnostic scripts for checking spawn, joints, and policy behavior.
    The setup was tuned iteratively through multiple training runs, then validated by training the flat LEGR task from scratch to 10k iterations. The final local checkpoint walks forward in play mode.
    [Abduction_L.STL, Abduction_R.STL, Calf_L.STL, Calf_R.STL, Flexion_L.STL, Flexion_R.STL, Foot_L.STL, Foot_R.STL]
2026-07-09 gripper VR teleop working, IK needs further tuning
2026-07-09 Collapse Quest teleop into single simulation_il container via native ROS2
    Eliminates the two-container UDP relay architecture (teleop + simulation_il).
    ROS2 Humble is now built from source inside simulation_il against Python 3.11
    (matching Isaac Sim 5.1's bundled interpreter ABI), so quest_teleop_node and
    the IK script run in the same container communicating over ROS2 topics directly.
    Removes quest_teleop_bridge.py and run_relay.sh (UDP middlemen no longer needed).
2026-07-09 Replace Differential IK with Pink IK and fix WSS cert trust flow
2026-07-09 Added push block task for so_arm_101
    [block.obj, box.obj]
2026-07-09 feat: implement MuJoCo MJX isolated pipeline for accelerated RL
    :wq
    [armDouble.SLDASM.csv, armDouble.SLDASM.urdf, base_link.STL, link1.STL, link1L.STL, link2.STL, link2l.STL, link3.STL]
2026-07-09 Clean up duplicate folders, reorganize push task files
    [block.obj, box.obj]
2026-07-09 chore: remove duplicate mojuco bimanual arm assets (pre-76aeb7f)
    [armDouble.SLDASM.csv, armDouble.SLDASM.urdf, base_link.STL, link1.STL, link1L.STL, link2.STL, link2l.STL, link3.STL]
2026-07-09 fix: resolve MuJoCo test script lint issues and reuse existing URDF assets
2026-07-09 migrate rl to new docker
    [hand_urdf.urdf]
2026-07-09 rename to bimanual arm
    [armDouble.SLDASM.csv, bimanual_arm.csv, bimanual_arm.urdf]
2026-07-10 Changed P matrix to have high uncertainty initially with velocity
2026-07-10 Seeded velocity with linear approximation in beginning
2026-07-10 Changed trajectory node to use PoseStamped sub, updated velocity seeding with more accurage dt info, chupdated trajectory pub to include a stamp
2026-07-10 added respawn logic if shuttle doesn't appear in frame for more than 3 seconds
2026-07-11 Potential fix for pull request finding
    [calibrate_arm.py]
2026-07-11 deployment files
    [hardware_mapping.yaml]
2026-07-13 Added cuRobo-based dataset generator for pick and place IL (#110)
    * Added cuRobo-based pick-and-place IL expert demo dataset generator
    * added more noise to path, cleaned up naming
    * forgot some files
    * created new environment for tray pick-and-place, updated readme, general cleanup
    * Remove cuRobo stack from shared isaac_lab Docker image
    * reverted names of usd files
    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
    [bimanual_arm_curobo.urdf]
2026-07-13 rl-locomotion-for-v1-leg (#120)
    [Abduction_L.STL, Abduction_R.STL, Ankle_L.STL, Ankle_R.STL, Calf_L.STL, Calf_R.STL, Flexion_L.STL, Flexion_R.STL]
2026-07-15 improve-locomotion-rl (#121)
    [Wato_Humanoid_V1_isaac.urdf]
2026-07-17 Fixing the IK for the VR Sim. (#119)
    * adding fixes for testing. Need see if the auto calibration works and follows up using office PC
    * Fixing the IK for the VR sim
    * new changes
2026-07-17 locomotion-rough-ground-rl (#142)
2026-07-17 Arm Interfacing tools (#143)
    * arm interfacing tools
    * fix
    * other fix
    [joint_command_core.cpp, joint_command_node.cpp]
2026-07-18 Vr changes (#149)
    * right arm working
    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
2026-07-18 mimicgen generated data (#135)
    * mimicgen
    * some cleaning
    * more cleaning
    * seperating pr
    * correction
    * more correction
    * Restore arm-interfacing files accidentally left out of mimicgen PR split.
    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
2026-07-18 RL-push-task-switch-to-bimanual-arm (#150)
2026-07-19 make-pioneer-arm-move (#155)
    * make-pioneer-arm-move
    * cleanup
2026-07-20 add-proper-calibration (#156)
    [bimanual_arm.urdf, bimanual_arm_curobo.urdf, hardware_mapping.yaml]
2026-07-20 fix clang-format violations in can_node.cpp
    [can_node.cpp]
2026-07-23 Adding safety check skill before running any scripts on the real Arm (#162)
    * Add .claude/ to .gitignore
    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
2026-07-23 adding POV VR teleop (#154)
    * adding POV VR teleop
    * Quest teleop: stereo head-fixed camera, real-arm bridge, OpenXR/CloudXR groundwork
    - Replace flat single-camera POV with a fixed stereo RealSense pair rendered
    as real per-eye textures inside the existing WebXR immersive session (true
    depth, no CloudXR dependency) -- camera precisely aimed at the arms' actual
    rest position via a computed look-at, not a guessed angle.
    - Add head_pose to QuestHandPose.msg/quest_message_parser.cpp (currently
    unused by the fixed camera, kept for a possible future head-tracked mode).
    - Add --publish-real-left-arm: bridges the live DLS IK solution to the real
    physical left arm via /behaviour/arm_pose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
2026-07-24 Changing Hardware Mapping to change positions of Motors (#163)
    * remove zeroing
    * remove other scripts
    * Remove accidentally-committed ov3660_camera.usd asset
    This unrelated camera USD asset was swept in by a broad `git add` in an
    earlier "other fix" commit alongside monitor_motor_feedback.py. It's not
    referenced anywhere in the codebase and isn't part of the arm-interfacing
    work this branch/PR is for.
    * Resolve unresolved merge-conflict markers in joint_command_node.cpp
    The armPoseCallback merge conflict from commit 6d1644e2 was left
    unresolved and committed as-is, breaking compilation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
    [hardware_mapping.yaml]
2026-07-31 Fix clang-format CI issue in foc.cpp (#170)
    [foc.cpp]
2026-08-10 Add wato_arm_v2 (armWithStand) USD asset (#172)
    Converted from the armWithStand URDF with a fixed base joint and
    the ground-clip fix applied, matching this repo's existing
    Isaac Sim asset conventions (base/physics/sensor/robot USD split).
    [armWithStand.csv, armWithStand.urdf, armWithStand_isaac.urdf, base_link.STL, link1.STL, link1L.STL, link2.STL, link2l.STL]
2026-08-22 Properly fix CI gate for empty build matrices (#186)
    * Properly fix CI gate for empty build matrices
    The previous fix (merged in #185) assumed an empty-matrix
    build-and-unittest job reports needs.result == "skipped", so the
    gate only failed on literal "failure". That assumption was wrong:
    GitHub reports needs.<job>.result as "failure" for a zero-entry
    matrix job, so the gate kept failing for the exact case it was
    meant to allow.
    Two real fixes:
    1. confirm-build-and-unittest-complete now reads the computed
    docker_matrix from setup-environment directly and checks its
    entry count, instead of trusting build-and-unittest's result.
    Zero entries = nothing to build for this diff = pass.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
2026-08-22 Adding the new URDF and USD files to the Repository + Removing unused USD/URDF files (#183)
    * new urdf + usd files
    * Remove accidentally-committed URDF exporter debug logs
    pioneer_bimanual_arm/export.log, pioneer_boxing_arm/boxingURDF/export.log,
    and pioneer_badminton_arm/export.log are raw stdout/debug output from the
    URDF export tool (8,954 lines combined, ~84% of this PR's total
    additions). They're not reproducible-build metadata or documentation --
    just tool output that adds no value in version control and would churn
    on every future re-export.
    Claude-Session: https://claude.ai/code/session_01Mzkt9bALC8oUqQKCN6upNm
    Co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
    [CMC_THUMB_v1_1.stl, DIP_INDEX_v1_1.stl, DIP_MIDDLE_v1_1.stl, DIP_PINKY_v1_1.stl, DIP_RING_v1_1.stl, IP_THUMB_v1_1.stl, MCP_INDEX_v1_1.stl, MCP_MIDDLE_v1_1.stl]
2026-08-25 Add isaac_screenshot harness for remote Isaac Sim scene iteration (#205)
    * Add isaac_screenshot harness for remote Isaac Sim scene iteration
    Claude Code Remote Control has no physical access to the monitor, so
    iterating on IsaacLab scenes remotely needs a way to launch a script,
    wait for it to be ready, and grab a real screenshot of the running GUI
    window — GNOME's screenshot D-Bus/portal APIs require an interactive
    click and don't work headless. Wraps xwd + a manual XWD->PNG decoder,
    plus the launch gotchas learned the hard way (no --experience flag,
    $DISPLAY varies across reboots, never SIGKILL Isaac Sim, Python stdout
    buffering hides print() markers).
    * Add multi-view + headless captu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
2026-08-25 Add persistent Isaac Sim session daemon for fast iterative scene building (#206)
    * Add persistent Isaac Sim session daemon for fast iterative scene building
    Every isaac_screenshot.sh / isaac_multiview_screenshot.sh command relaunches
    Isaac Sim from scratch (~15-40s even with a warm shader cache) — fine for a
    single check, wasteful when iterating on the same scene repeatedly (nudging
    object positions, checking several placements against a screenshot, building
    up a scene incrementally). This adds a long-lived alternative: one Isaac Sim
    process stays running and takes commands over a file-based queue shared with
    the host via the repo's existing bind mount, so each command afterward costs
    a f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
2026-08-25 Rename isaac_screenshot to isaac_harness, fix bimanual arm spawn (#207)
    * Rename tools/isaac_screenshot -> tools/isaac_harness
    The folder started as just a screenshot capture tool but grew into a
    full session daemon with structured scene introspection — the name
    undersold what's actually in there now.
    * Add spawn_bimanual_arm daemon command and a reusable vial-rack scene script
    Generic spawn_usd --articulation builds a bare ArticulationCfg with no
    actuators and fails outright for this repo's actual robot:
    TypeError: Missing values detected in object ArticulationCfg for
    the following fields:
    - actuators
    spawn_bimanual_arm spawns it correctly instead, using the real
    BIMANUAL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
2026-08-25 Fix daemon ground plane offset, add isaac-harness Claude skill (#208)
    * Set daemon's ground plane to the robot's actual bbox-derived Z
    Was hardcoded at 0.0 (visibly intersecting the table/robot base) then
    manually tuned to -1.0 by trial and error across several screenshots.
    Queried bbox on the spawned Robot instead: true lowest point is
    z=-1.1997, meaning -1.0 was still cutting ~0.2m into the base mount
    (not obvious from render angles since that part of the mesh is thin).
    -1.2 puts the tripod base feet flush on the floor, confirmed visually
    (the feet are now visible at all, previously hidden below ground).
    * Add isaac-harness Claude Code skill
    Captures the hard-won lessons from building t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
2026-08-25 Remove non-functional apply_physics option from spawn_usd
    spawn_usd's --apply-physics flag did not successfully enable physics
    for bare-mesh USD assets with no baked-in RigidBodyAPI (e.g. YCB
    props) — spawning such an asset still failed with a missing-rigid-
    body error regardless of the flag. Removes the option and its
    client-side arguments; root cause remains open in a follow-up issue.
    Retains the unrelated, verified-working fix from the prior commit:
    process_command now clears builtins.ISAACLAB_CALLBACK_EXCEPTION after
    every call, so a failed spawn's stored exception is not re-raised and
    misattributed to subsequent, unrelated commands.
2026-08-26 Fix set_pose not surviving reset, and remove corrupting other Articulations
    Both were previously open, documented workarounds in issue #209 — real
    root causes found this time, not further guesses.
    set_pose: a real (non-soft) sim.reset() calls PhysX stop() then play(). On
    PLAY, a rigid body's pose is re-initialized from the USD prim's authored
    xformOp transform on the stage, not from cfg.init_state or
    data.default_root_state (both of which two earlier fix attempts targeted).
    write_root_pose_to_sim() only ever writes the live physics tensor, never
    the prim's actual USD attributes (confirmed: query() reflected a new pose
    instantly, but bbox() of the same prim right after showed the transform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
2026-08-30 Remove wato_constants.py; keep only pick-place task geometry
    `wato_constants.py` existed as an Isaac-free mirror of the arm's joint
    limits / default pose / EE bodies so the cuRobo pipeline could import them
    without pulling in isaaclab. cuRobo was archived in PR #187 and every
    remaining importer runs inside Isaac Lab, so the arm half is now redundant
    (and had drifted — the held-arm default pose no longer matched
    bimanual_arm_cfg.py).
    - Delete wato_constants.py (137 lines).
    - Add pick_place_gen/task_geometry.py (56 lines): only the constants actually
    consumed — table slab, workspace box, grasp-yaw count, tray geometry, and
    the gripper approach frame (FINGERTIP_OFFSET_IN_WRIST / APPROA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
2026-08-31 Retarget Quest teleop to pioneer_bimanual_arm (#218)
    * Add Quest VR teleop for wato_arm_v2 (armWithStand)
    Adapts run_quest_bimanual_teleop.py for the new armWithStand.usd
    asset: dedicated armWithStand_v2_cfg.py (joint limits/gains/
    fingertip geometry re-derived for this asset's different joint
    axes, not copied from bimanual), the VR teleop script itself with
    a live-tuned stereo RSD455 head camera, a single-arm keyboard
    teleop variant for quick bench testing, and a helper script to
    open the bare USD scene for visual inspection.
    * Tune stereo head camera position/orientation via live feedback
    Restored a clean forward-facing gaze (~50d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
    [pioneer_bimanual_arm.urdf]
2026-08-31 Consolidate the pioneer_bimanual_arm config into the pioneer_humanoid package (stacked on #218) (#221)
    * consolidate: pioneer_bimanual_arm_cfg.py is the one canonical arm config
    - rename armWithStand_v2_cfg.py -> pioneer_bimanual_arm_cfg.py,
    ARM_V2_CFG -> PIONEER_BIMANUAL_ARM_CFG
    - split the data-collection camera config (ego_cam/wrist_cam) out to
    teleop_cameras.py -- it is teleop-scene setup, not a robot property
    - repoint run_quest_bimanual_teleop.py at both
    No behaviour change.
    Claude-Session: https://claude.ai/code/session_01EtusD8QWFBLpdMUZPpye5B
    * consolidate: delete bimanual_arm_cfg.py, migrate all consumers to pioneer_bi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
2026-09-01 keyboard teleop: persistent absolute-pose IK + Shift for fine control
    The IK felt laggy/mushy vs task_space_ik.py. Two causes:
    1. Relative mode (use_relative_mode=True) re-anchored the target to the
    *measured* tip every step, so a held key made the arm chase a moving
    carrot -- steady-state lag, and it stalled near joint limits while you
    kept pressing.
    2. apply_delta_pose composes the rotation delta as quat_mul(delta, current)
    -- pre-multiply -- so Z/X/T/G/C/V rotated about the base axes, not the
    tool axes, which tumbles a tilted wrist unexpectedly.
    Now (matching task_space_ik.py): absolute-pose mode against a persistent
    target seeded from the tip, integrating the keyboard de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
2026-09-01 keyboard teleop: add --scene {bare,push}; restore box.usd
    keyboard_teleop.py always built the bare ground+light+arm scene. New
    pioneer_humanoid.teleop_scenes module:
    bare (default) ground + light + arm -- unchanged behaviour
    push arm on its floor stand facing a lightbox enclosure + work
    table, with the push-block ramp-box + block on the table
    The push scene puts the arm on the ground (lifted 1.1997 m onto its stand,
    feet at z=0) facing the table -- NOT the old RL push layout where the arm
    sat at table height. Table + lightbox geometry come from the Quest scene
    (run_quest_bimanual_teleop.py); the ramp-box (box.usd) and block (block.usd)
    keep push_env_cf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
2026-09-01 ci: add pre-commit (checks only) + protect watod-config.sh
    - .pre-commit-config.yaml: structural checks — large-file guard (blocks
    accidental multi-hundred-MB asset commits), merge-conflict / case-conflict
    / symlink / submodule checks, Python-parses, TOML-valid. No whole-repo
    reformat; formatters can be layered on later.
    - pre-commit.yml: runs `pre-commit run --all-files` on every PR + main push.
    - block_watod_config_change.yml: fails a PR that edits watod-config.sh
    (shared defaults) — personal settings belong in watod-config.local.sh.
    Run `pre-commit install` once locally to get the git hook.
    Claude-Session: https://claud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
2026-09-01 Rename autonomy/ -> src/ ; move embedded/ -> src/embedded/
    Standardise the first-party source layout: everything under src/ (ROS
    packages, sim, teleop, IL), with firmware in src/embedded/ alongside them.
    "autonomy/" never matched what's in there anyway.
    Pure move + reference update:
    - git mv autonomy src ; git mv embedded src/embedded
    - sweep autonomy/ -> src/ and embedded/ -> src/embedded/ in Dockerfiles,
    compose files, watod scripts, CI (check_src_changes, linting), setup.cfg,
    .gitignore, .clang-format-ignore, all READMEs, and the few hard-coded
    paths in Python (isaac_session_daemon, teleop docstrings/help text)
    - parents[N] path anchors are unchanged (folder depth is identical)
    py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
    [Ankle_L.STL, Ankle_R.STL, Calf_L.STL, Calf_R.STL, Foot_L.STL, Foot_R.STL, Hip_A_L.STL, Hip_A_R.STL]
2026-09-01 watod: collapse to one editable container per module
    Drop the deploy/dev split entirely. This repo has no autonomous robot
    operation and CI doesn't exercise the deploy stage, so the duality (global
    MODE_OF_OPERATION, a <module> + <module>_dev service pair, deploy/develop
    profiles) was cost with no benefit -- and for most modules the two services
    were near-identical anyway.
    Now: ACTIVE_MODULES="interfacing simulation_isaac" -> one bind-mounted,
    editable container per module. Shell in with `watod -t <service>`, launch /
    rebuild by hand.
    - modules/*.yaml: collapse each module's two services into one (keeping the
    dev variant's command + the bind mount), remove every `profiles:` line,
    drop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
2026-09-01 Fix stale clang-format-ignore path after autonomy/ -> src/ rename
    #229's rename swept autonomy/ -> src/ but left the FreeRTOS-Kernel exclude
    as `embedded/STM32/lib/**` (now `src/embedded/STM32/lib/**`), so clang-format
    started failing on ~30 vendored third-party files on every PR.
    Verified: full-repo clang-format --dry-run --Werror is clean.
    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
2026-09-01 clang-format: actually exclude vendored FreeRTOS-Kernel
    The CI clang_format check (wato-lint-action) globs every C/C++ file and runs
    clang-format on it explicitly. It does NOT honour .clang-format-ignore
    (that needs a clang-format version / invocation the runner doesn't have),
    so the ~31 vendored FreeRTOS-Kernel files under src/embedded/STM32/lib/ have
    been failing the check with tens of thousands of "errors" on every PR.
    Fix: a nested `.clang-format` with `DisableFormat: true` in that dir. That
    is honoured by every clang-format version regardless of how it's invoked, so
    the vendored files become a no-op. Verified: full first-party C/C++ sweep is
    clean, with and without .clang-format-ignore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
2026-09-01 dev containers: run as the host user (no root-owned bind-mount files)
    Each module Dockerfile gains a `develop` stage that creates a user matching
    the host UID/GID (passed by watod as build args) and switches to it. Files a
    dev container writes into the bind-mounted src/<module> come out owned by
    you, not root -- no more sudo to clean colcon build output / __pycache__.
    - docker/{interfacing,perception,behaviour/*,simulation/mjlabs}.Dockerfile:
    + develop stage (useradd + passwordless sudo + chmod 711 /root so the
    non-root user can traverse into /root/ament_ws + chown the workspace)
    - modules/*.yaml: build.target=develop, pass USER_UID/USER_GID/USERNAME
    - watod-setup-docker-env.sh: write U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
2026-09-01 sim: promote pioneer_humanoid to a top-level src/ package (#247)
    [armv2URDF.csv, base_link.STL, link1.STL, link1L.STL, link2.STL, link2l.STL, link3.STL, link3l.STL]
2026-09-01 modules: dissolve `behaviour` into interfacing + perception
    The `behaviour` module held joint_command and voxel_grid/octo_map -- none of
    which is "behaviour" in the autonomy-stack sense (planning / decision FSM). The
    name was carried over from an AV monorepo; this repo is end-to-end learned
    policy and has no behaviour layer.
    - joint_command -> src/interfacing/joint_command/ (it only exists to feed the
    CAN layer: ArmPose -> calibrate + safety-moderate -> MotorCmd -> can; always
    deployed with interfacing). Now a second service in docker-compose.interfacing.
    - voxel_grid + octo_map -> src/perception/{voxel_grid,octo_map}/ (depth ->
    occupancy world model). src/perception/ becomes a mult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
    [hardware_mapping.yaml]
2026-09-01 push: one scene module, on the teleop-verified grounding (#250)
2026-09-02 robots: consolidate modelCfg into pioneer_humanoid, drop the "wato" name (#257)
    The RL robot configs lived 4 dirs deep in HumanoidRLSetup/modelCfg/. They're
    robot configs, not RL — move them flat into the pioneer_humanoid package
    alongside bimanual_arm.py, and rename off the old org name:
    modelCfg/humanoid_arm_hand.py -> pioneer_humanoid/arm_hand.py
    modelCfg/wato_hand.py -> pioneer_humanoid/hand.py
    modelCfg/wato_humanoid_v1.py -> pioneer_humanoid/whole_body.py
    INHAND_WATO_HAND_CFG -> INHAND_HAND_CFG
    WATO_HUMANOID_V1_CFG -> WHOLE_BODY_HUMANOID_CFG
    Consumers (badminton, inhand x3, locomotion, camera_teleop, splay_demo) now
    `from pioneer_humanoid.<name> import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
2026-09-02 teleop_scenes.py -> humanoid_scenes; teleop_cameras.py -> src/teleop/ (#259)
    pioneer_humanoid is the robot-configs package; teleop scene wiring and recording
    cameras don't belong in it.
    - teleop_scenes.py deleted. Its jobs move into humanoid_scenes:
    - the `bare` scene -> humanoid_scenes/bare/scene.py (@scene("bare"))
    - the `push` legacy shim -> humanoid_scenes/push_block/scene.py (sys.path into
    HumanoidRLPackage + re-register the imported PushBlockSceneCfg; replaced by
    the real scene when push is flattened, #245)
    - scene_names/build_scene_cfg/camera_for were already covered by
    humanoid_scenes.list_scenes / make_scene_cfg / scene_camera
    - keyboard_teleop uses humanoid_sce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
2026-09-02 sim: flatten RL runner + tasks into src/ packages (humanoid_rl, humanoid_rl_tasks) (#260)
    First step of the src/simulation/ RL-tree flatten (#245). Extracts the two
    least-active tasks and the shared runner out of the deeply-nested
    Humanoid_Wato/HumanoidRL/HumanoidRLPackage/HumanoidRLSetup/ tree:
    - src/simulation/humanoid_rl/ — installable; RSL-RL train/play/diagnose
    runners (was HumanoidRLPackage/rsl_rl_scripts/, minus the push-specific
    distill scripts which move with push later)
    - src/simulation/humanoid_rl_tasks/ — installable; flat one-folder-per-task,
    seeded with inhand + locomotion. __init__ registers envs via import_packages,
    same mechanism Isaac Lab's own suite us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
2026-09-02 Archived: remove the Isaac Lab badminton task (#265)
    Superseded by the mjlab badminton environment (#179) — a full rewrite on the
    simulation_mj stack with a v2 arm + racket, court, and aerodynamics. The Isaac
    version was the earlier attempt and its only robot config (arm_hand.ARM_CFG)
    points at a USD that was deleted in #183.
    `arm_hand.py` / `ARM_CFG` is now used only by src/teleop/camera_teleop/, which
    is being archived in a follow-up.
    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
2026-09-02 Archived: remove camera_teleop + dead arm_hand.py (#266)
    * Archived: remove the Isaac Lab badminton task
    * Archived: remove camera_teleop + the dead arm_hand.py config
    camera_te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
2026-09-02 reorg: shared USD props -> src/simulation/assets/; drop dead badminton arm dir (#267)
    - UsdModelAssets/{block,box}.usd + Table/table.usd -> src/simulation/assets/
    (consumers: push_block scene, quest_isaac_teleop)
    - pioneer_badminton_arm/ + empty arm_assembly/ deleted — zero references
    (badminton is mjlab now, #179)
    pioneer_boxing_arm/ kept for now — pending confirmation it's unused by Ramy's
    AMP / motion-prior work.
    Part 1 of dissolving src/simulation/Humanoid_Wato/. wato_hand/ and the V1
    humanoid model fold into pioneer_humanoid/ next.
    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
    [badmintonURDF.csv, base_link.STL, link1.STL, link1L.STL, link2.STL, link2l.STL, link3.STL, link3l.STL]
2026-09-02 reorg: fold wato_hand/ into pioneer_humanoid/ (Humanoid_Wato part 2) (#268)
    - Humanoid_Wato/wato_hand/wato_hand_cfg.py -> pioneer_humanoid/pioneer_humanoid/hand_cfg.py
    (symbol WATO_HAND_CFG -> HAND_CFG)
    - Humanoid_Wato/wato_hand/{urdf,meshes,config} -> pioneer_humanoid/assets/hand/
    - hand.py drops the sys.path hack -> `from .hand_cfg import ...`
    - dead ROS/gazebo scaffolding (CMakeLists, package.xml, launch/, export.log) removed
    - splay_demo.py removed — unreferenced one-off demo (in git history if needed)
    Humanoid_Wato/ now down to the V1 humanoid model + Ramy's boxing arm.
    Claude-Session: https://claude.ai/code/session_01EtusD8QWFBLpdMUZPpye5B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
    [abduction_1.STL, distal_1.STL, distal_2.STL, distal_3.STL, distal_4.STL, finger_1.STL, finger_2.STL, finger_3.STL]
2026-09-02 reorg: V1 humanoid model -> assets/whole_body_humanoid/; RL checkpoints -> outputs/rl/; delete Humanoid_Wato/ (#269)
    Part 3 (final) of dissolving src/simulation/Humanoid_Wato/.
    Asset move / rename:
    - "Wato Humanoid Simultion Model V1/urdf/Wato_Humanoid_V1_isaac{.urdf,_usd/}"
    -> src/simulation/assets/whole_body_humanoid/{whole_body_humanoid.urdf, usd/}
    - top USD Wato_Humanoid_V1.usd -> whole_body_humanoid.usd
    - meshes/ -> assets/whole_body_humanoid/meshes/
    - raw SolidWorks export (space-named files) + dead ROS scaffolding: deleted
    - pioneer_boxing_arm/ deleted (preserved in Ramy's branch)
    - Humanoid_Wato/ is gone
    RL checkpoints:
    - train.py / play.py / distill_push.py log_root -> $HUMANOID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
    [Ankle_L.STL, Ankle_R.STL, Calf_L.STL, Calf_R.STL, Foot_L.STL, Foot_R.STL, Hip_A_L.STL, Hip_A_R.STL]
2026-09-02 reorg: all robot/prop assets -> repo-root assets/ (backend-neutral) (#270)
    URDF/USD/meshes are robot description consumed by any sim backend; keeping them
    under src/pioneer_humanoid/ (an Isaac Lab package) or src/simulation/ couples
    them to one backend. Move to the repo root, alongside the existing assets/lerobot/.
    - src/pioneer_humanoid/assets/pioneer_bimanual_arm/ -> assets/pioneer_bimanual_arm/
    - src/pioneer_humanoid/assets/hand/ -> assets/pioneer_hand/
    - src/simulation/assets/whole_body_humanoid/ -> assets/whole_body_humanoid/
    - src/simulation/assets/{block,box,table}.usd -> assets/props/
    - urdf_joint_limits.py (was living in the arm asset dir, imported via sys.pa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
    [Ankle_L.STL, Ankle_R.STL, Calf_L.STL, Calf_R.STL, Foot_L.STL, Foot_R.STL, Hip_A_L.STL, Hip_A_R.STL]
2026-09-02 sim: drop the last "wato" naming from the RL task configs (#272)
    Renames the locomotion + inhand task configs to match the assets they use
    (assets/whole_body_humanoid, assets/pioneer_hand) and the pioneer_humanoid
    package:
    locomotion:
    - config/wato_humanoid_v1/ -> config/pioneer_humanoid_v1/
    - WatoHumanoid{Rough,Flat}{EnvCfg,Rewards,Terminations,PPORunnerCfg} -> PioneerHumanoid*
    - WATO_{LEG,FOOT,ANKLE}_JOINTS / WATO_BASE_BODY -> {LEG,FOOT,ANKLE}_JOINTS / BASE_BODY
    - gym: Isaac-{Locomotion,Velocity}-{Flat,Rough}-WatoHumanoid*-v0 -> *-PioneerHumanoid*-v0
    - experiment_name wato_humanoid_{flat,rough} -> pioneer_humanoid_{flat,rough}
    inhand:
    - config/wato_hand/ -> config/pioneer_hand/ ; wato_ha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
2026-09-02 sim: promote 5 RL policy baselines to models/; delete Humanoid_Wato/ for good (#274)
    The only thing keeping src/simulation/Humanoid_Wato/ alive was ~19 MB of old
    committed training checkpoints under HumanoidRL/logs/. Curate the useful ones,
    drop the rest, delete the directory.
    - models/{push, push_distill, pioneer_hand_cube, pioneer_humanoid_flat,
    pioneer_humanoid_rough}/ — one .pt each, the baselines worth sharing
    (dirs renamed to the post-#272 task names)
    - removed: cabinet_humanoid_arm/ + reach_humanoid_arm/ checkpoints (tasks deleted
    long ago) and every intermediate model_N / tfevents / params file
    - new models/README.md — baselines vs live runs (outputs/rl/, gitignored)
    - Hum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
2026-09-17 Merge pull request #179 from WATonomous/s532yang/badminton-rl
    sim: badminton receive RL environment (mjlab, stationary arm)
2026-09-19 sim: fix eval reset/RTC autograd bugs, add generic RTC driver for flow-matching policies (#286)
2026-10-01 Pioneer v1 sim schema, gripper fix, camera recording (#297)
    * Pioneer v1 sim schema + keyboard teleop gripper fix
    - keyboard_teleop: drop the line that overwrote right_gripper_ids with the
    idle arm's joint7/joint8, so K now drives the teleoperated arm's gripper.
    The idle arm's fingers are held open via HELD_GRIPPER_* instead.
    - Recording: 7 values per frame (6 arm joints + gripper closure 0-1), one
    frame every 4th physics step (25 fps at 100 Hz physics), rate_limit=False.
    _init_recorder validates joint_names and that fps divides the physics rate.
    - dataset_schema_sim.yaml: pioneer_v1_left_arm_sim, real-robot joint names,
    fps 25, gripper added.
    - il README updated to match.
    Co-Aut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
2026-10-01 One Pioneer v1 dataset schema for sim and real (#299)
    * il: one Pioneer v1 schema for sim and real recording
    - dataset_schema_pioneer_v1.yaml replaces dataset_schema.yaml (real) and
    dataset_schema_sim.yaml: 7 joints (6 + left_gripper), 25 fps, cameras
    ego / wrist_left / wrist_right at 256x256. Sim writes <root>/sim, real
    writes <root>/real.
    - schema.select_cameras(): shared --cameras handling for keyboard_teleop
    and humanoid-record.
    - humanoid-record: stops at startup when the schema needs something the
    real arm can't supply yet (left_gripper, cameras without a topic);
    center-crops and resizes camera frames to the schema size; dry run
    uses schema image sizes; robot_type comes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
    [dataset_schema_pioneer_v1.yaml]
2026-10-01 Rename src/il to src/robot_learning; remove SO101 teleop (#301)
    * rename src/il -> src/robot_learning (humanoid_robot_learning)
    - Folder src/robot_learning, package humanoid_robot_learning, pip
    humanoid-robot-learning; CLI humanoid-record unchanged.
    - Isaac image aliases: train-policy, record-demos, eval-policy
    (were il-train, il-record, il-eval).
    - All imports, paths and docs updated (teleop, so101_vial_task, Dockerfile,
    READMEs, DEVELOPING.md).
    - README: robot_learning = learning from recorded datasets (ACT, SmolVLA,
    pi0.5); RL is sim-based (Isaac Lab) and stays in src/simulation/humanoid_rl*.
    Also drops the stale pick_place entry from the repo map.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
2026-10-01 teleop: Pioneer leader-arm teleop (any scene, recording) (#305)
    * teleop: pioneer_leader_teleop (7-servo leader arm, any scene, recording)
    Moves NotMax08's leader-arm code from #296 into src/teleop/pioneer_leader_teleop:
    - servo_leader.py, encoder_test.py: as in #296, minus the 5-servo map and the
    vendored-SDK path (feetech-servo-sdk is in the Isaac image).
    - arm_limits.py: gripper_fraction / limited_target; joint targets are clamped
    to the arm's URDF limits instead of the leader's travel; a NaN reading holds
    the home pose.
    - pioneer_leader_teleop.py: from #296's leader_teleop.py and recorder values
    (signs 1,-1,-1,1,1,-1,1, scales 0.7/1.0, filter 0.35, wrist damping 2.5,
    leader ze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
2026-10-01 teleop: group Quest teleop under quest_teleop/{bridge,sim} (#306)
    - quest_teleop/ (C++ WebXR -> /quest_teleop bridge) -> quest_teleop/bridge/
    - quest_isaac_teleop/ (Isaac Sim consumer) -> quest_teleop/sim/
    - ROS package names unchanged (quest_teleop, quest_isaac_teleop); only paths move.
    - Certs stay at src/teleop/quest_teleop/certs (same docker mount); webxr_server's
    default cert dir follows. Path depths, scripts, .gitignore and docs updated.
    - New quest_teleop/README.md overview.
    Claude-Session: https://claude.ai/code/session_01L3sXcHSNxWVrXacUmXh1Fh
2026-10-01 Robot cameras into pioneer_humanoid; datasets under the repo root (#307)
    - pioneer_humanoid/cameras.py: the robot's mounted cameras (ego D455, wrist
    cameras), was make_record_cam_cfg in src/teleop/teleop_cameras.py. Now
    CAMERA_NAMES / make_camera_cfg.
    - quest_teleop/sim/quest_cameras.py: the Quest-only ego/wrist cameras.
    - record_utils.resolve_dataset_root(): a relative record.root resolves against
    the repo root, so data lands in <repo>/datasets/ wherever a recorder is
    launched from (keyboard, leader arm, Quest, humanoid-record).
    - README: sim output path (no 001/ folder; sessions append), training example.
    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
    [dataset_schema_pioneer_v1.yaml, pioneer_leader_arm_teleop.py]
2026-10-01 teleop: shared sim recording setup; task-space gripper fix (#308)
    * task_space_ik: hold the active (left) gripper open
    A second assignment overwrote right_gripper_ids with the idle gripper's joints.
    * teleop: share sim recording setup between keyboard and leader-arm teleop
    Record args, schema loading and SimLeRobotRecorder setup move to
    humanoid_robot_learning.sim_teleop_record. Drops keyboard's unused --sink.
    Co-authored-b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
    [pioneer_leader_arm_teleop.py]
2026-10-01 simulation: MuJoCo peg-insertion scene driven by the leader arm
    - pioneer_humanoid: arm_params.py (simulator-neutral pose, joints, gains; bimanual_arm.py reads it)
    and mujoco_arm.py (URDF -> MuJoCo with the same limits/gains, box finger collisions).
    - mujoco_scenes: humanoid_mujoco_scenes registry, bare and peg_insert scenes, preview.py.
    - pioneer_leader_arm_teleop: --sim isaac|mujoco; Isaac loop moved to isaac_sim.py, mapping shared
    in leader_mapping.py, new mujoco_sim.py.
    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
    [isaac_sim.py, leader_mapping.py, mujoco_sim.py, pioneer_leader_arm_teleop.py]
2026-10-01 Merge pull request #311 from WATonomous/claude/tender-davinci-qayyj0
    teleop: MuJoCo recording for the leader arm; simulation_mj image for it
2026-10-02 teleop: leader arm maps 1:1 from a calibrated hanging zero; home = elbow 90
    - calibrate_leader.py stores the hanging-pose zero (leader_calibration.json); no re-zero at startup or R.
    - Joint target = sign x leader angle (gain 1.0); hanging = URDF zero = real arm's zero.
    - DEFAULT_JOINT_POS elbows +/-90 (home: forearm forward, above the table).
    - The arm follows only once the leader is within 3 deg of home, gripper open (startup and after R);
    no frames recorded before that.
    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
2026-10-02 Usermod home-dir fix (#312)
    * docker: keep AMENT_WS home dir on user remap, fix FastDDS discovery across users
    - develop stage: don't `usermod -m` (AMENT_WS lives in the old home); seed the new home from /etc/skel.
    - joint_command / perception compose: drop the working_dir override so the relative ENTRYPOINT resolves.
    - joint_command compose: UDP-only FastDDS, so `docker exec` nodes under another user discover peers.
    * Update modules/docker-compose.perception.yaml
    * Update modules/docker-compose.interfacing.yaml
    * Update docker/perception/voxel_grid/voxel_grid.Dockerfile
    * Update docker/perception/perception.Dockerfile
    * Update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
2026-10-02 joint_command: MIT gains and watchdog, tick-based limit pipeline
    - Moderation runs on the control tick, not per ArmPose: velocity_max is a true deg/s bound.
    Low-pass now runs before the rate limits (the old order capped speed at (1 - alpha) * max);
    a clamp that bites is rate-limited instead of snapping.
    - Per-joint control_type. MIT joints get kp/kd, a startup stall-torque check, and a latching
    watchdog (torque, tracking error, feedback age, drive status per family). AK joints damp on
    fault instead of going limp; pre-shutdown damping then MIT_EXIT on Ctrl-C.
    - Joints with no feedback or outside their limits at seeding are excluded, not ramped from 0.
    - hardware_mapping.yaml: recalibr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
    [hardware_mapping.yaml]
2026-10-02 can: MIT control for GL II and AK drives
    - mit_protocol.{hpp,cpp}: pure packing/decoding for GL II (GL40) and AK V3 MIT frames, with gtests
    against the manuals' worked examples, a bench capture and the DBC layout.
    - can_node: AK V3 extended-frame commands, GL II special frames (ENTER/EXIT/SET_ZERO/CLEAR_ERRORS),
    GL II feedback on the master id, AK torque = current * kt. Gains snap to the nearest 12-bit code.
    - humanoid.dbc: MITControlCmd as a standard frame in protocol byte order (pos, vel, kp, kd, t).
    - MotorCmd / MotorFeedback: MIT special-frame types and a feedback torque field.
    - mit_profiles.yaml: per-motor family (ak | gl2), kt, GL40 entries. setup_socketcan.sh for gs_usb.
    Co-Auth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
    [can_node.cpp, can_node.hpp, mit_protocol.cpp, mit_protocol.hpp, params.yaml, test_mit_protocol.cpp]
2026-10-02 can: arm_roundtrip benchmark and telemetry recording
    - arm_roundtrip.py (+ tools/arm_roundtrip.sh): ramps a pose out and back through ArmPose ->
    joint_command, so the benchmark runs under teleop's limits. Preflight refuses when another
    publisher is up, a moving joint is silent / near a limit, or the node's installed configs
    differ from the repo's. --exercise-limits checks the clamp and velocity limit.
    - telemetry_record.py / telemetry.py: per-tick CSV + run.json under outputs/gl40_bench/
    (stdlib only), with pass/fail checks on limits and velocity.
    - tools/gl40_telemetry_plot.py: host-side plots (uv run --with matplotlib --with numpy).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
    [arm_roundtrip.py, gl40_telemetry_plot.py, telemetry.py, telemetry_record.py]
2026-10-02 joint_command: URDF gravity feed-forward on MIT joints
    - gravity_model.cpp: static hold torque of the left arm from the URDF masses (checked against a
    numpy reference in the gtests).
    - MIT joints may send it as MotorCmd.torque: scaled, clamped to gravity_ff_max_torque, ramped in
    over 1 s after each seed, and zeroed while any joint angle is unknown. The startup torque
    check includes the feed-forward cap.
    - Per-joint cmd -> URDF mapping (urdf_direction / urdf_offset_deg), gravity_assume_deg for
    single-motor testing, and a pred-vs-measured log for bring-up.
2026-10-03 Garment-fold task for the pioneer bimanual arm (from LeHome Challenge) (#219)
    * Add garment-fold task for the pioneer bimanual arm
    Bimanual garment-folding Isaac Lab task (DirectRLEnv), ported from the LeHome
    Challenge and retargeted from 2x SO101 to one pioneer_bimanual_arm.
    - src/simulation/garment_fold_task/ : installable humanoid_garment_fold package
    (vendored GarmentEnv + particle cloth + success checker + reward; new
    GarmentPioneerEnv subclass; gym id Humanoid-GarmentFold-Bimanual-Pioneer-v0)
    - 4 sample garments + a fallback table committed under vendor_assets/;
    Scene_00_Apartment.usd/.usdz are .gitignore'd (copy from the HF asset set)
    - isaac_lab.Dockerfile: COPY + editable-in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
2026-10-04 robot_learning: pi0.5 fine-tuning for the Pioneer left arm
    src/robot_learning/humanoid_il/pi0.5/: train pi0.5 (lerobot/pi05_base) on the
    notmaxxx/pioneer_vla_pick_place dataset with the VLM frozen and delta joint actions.
    - pioneer_train_cloud.py: 48 GB GPU (A40 / A6000), fp32 weights + bf16 autocast, the frozen
    prefix detached from autograd (bit-identical grads, ~3x faster), warmup-stable-decay LR,
    wandb logging, final checkpoint pushed to the Hub
    - pioneer_train_limited.py: same recipe sized for a 12 GB GPU
    - pioneer_eval_offline.py: predicted vs recorded action chunks on a held-out episode
    - action_space.py: delta <-> absolute joint actions and their normalization stats
    Isaac Lab imag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
2026-10-04 MuJoCo scenes: fix flaky grasp contacts in leader-arm data collection (#330)
    * MuJoCo scenes: fix flaky grasp contacts in leader-arm data collection
    A grasped peg spun and slid out of the jaws (35-100+ mm slip, 30-100 deg) and
    sank up to 12 mm into the fingers. Causes: no joint armature, so the light
    forearm/wrist form a mode too fast for the step that grasp contacts excite
    (fingers chatter, contacts drop out); plus MuJoCo's soft default contacts.
    - arm joints get 0.01 kg m^2 armature (reflected motor inertia)
    - 1 ms step, elliptic cones, impratio 10, solref 0.004 / solimp 0.95-0.99
    - grasp_check: headless scripted pick-lift-carry that fails on slip/spin/chatter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
